Haveroahl/1D-CNN-Accelerator-for-ECG-Arrhythmia-Classification-on-FPGA/Paper_Proposal_Q3.md

# Q3 Paper Proposal — Reconfigurable INT8 CNN Accelerator for Multi-Dataset ECG Arrhythmia Classification on Intel Cyclone V FPGA

**Tác giả**: Lê Đức (ducle160499@gmail.com)
**Ngày**: 2026-05-24 (cập nhật 2026-06-01)
**Target venue**: Electronics (MDPI) hoặc Sensors (MDPI) — Q3, IF ~2.9–3.4

---

## 1. Tiêu đề đề xuất

> **"Power-of-Two QAT and Cross-Dataset Transferability of an INT8 1D-CNN ECG Classifier on FPGA: A Bit-Exact Methodology and Empirical Study"**

Tiêu đề phụ ngắn (nếu Letter):
> *"Bit-Exact Power-of-Two INT8 1D-CNN for ECG on Cyclone V: Quantization Methodology and Chapman↔PTB-XL Transfer Study"*

### Pitch novelty (một câu để cover letter / abstract)
> "This paper presents (i) a bit-exact power-of-two QAT methodology for 1D-CNN ECG classification with quantitative ablation against general-scale INT8, and (ii) the first empirical cross-dataset transfer study (Chapman ↔ PTB-XL) on an FPGA-deployed quantized ECG model, enabled by a lightweight runtime weight-reload mechanism on Intel Cyclone V."

**Lưu ý chiến lược**: Runtime-reconfigurable weight được pitch là **enabling mechanism**, KHÔNG phải đóng góp chính — vì kỹ thuật này phổ biến trong FPGA NN accelerator (DPU, FINN, NVDLA). Đóng góp chính là (a) methodology QAT power-of-2 bit-exact và (c) empirical cross-dataset study.

---

## 2. Motivation & Gap Statement

### 2.1. Vấn đề
- ECG arrhythmia là nguyên nhân đột tử tim hàng đầu; phát hiện sớm bằng wearable / edge device cứu được rất nhiều ca.
- CNN 1D đạt accuracy cao nhưng deploy trên MCU không đủ throughput, deploy trên GPU không phù hợp wearable (power, form-factor).
- FPGA Cyclone V là sweet-spot: low-power, parallelism đủ cho CNN nhỏ, có HPS để host driver.

### 2.2. Gap của các công trình trước (sẽ chứng minh trong Related Work)
| Hạn chế thường thấy trong ECG-FPGA literature | Hướng giải quyết của paper này |
|---|---|
| Dùng power-of-2 shift nhưng **floor truncation** (Liu 2023) + không phân tích cost-accuracy power-of-2 vs general-scale | ⭐ **Round-half-up rescale (+0.38% vs floor) + ablation định lượng** power-of-2 vs general-scale vs floor (DSP, energy, accuracy) |
| Báo accuracy float vs INT8 nhưng không bit-exact với RTL → "INT8 simulation" và RTL thường lệch | ⭐ **Round-half-up bit-exact pipeline** (21 checkpoint match Python ↔ RTL) |
| Đánh giá chỉ trên 1 dataset, không trả lời được câu hỏi generalization | ⭐ **Empirical cross-dataset study** Chapman ↔ PTB-XL trên FPGA thực |
| Chỉ báo accuracy + LUT/FF, thiếu Energy/inference (chỉ số quan trọng cho wearable) | **Đo Power qua PowerPlay + Energy/inference µJ** |
| Hard-code weight bitstream → không thể làm transfer learning study trên hardware | Lightweight Avalon-MM weight reload (enabling mechanism, không phải novelty) |

### 2.3. Đóng góp (Contribution list — đưa vào Introduction)

**Đóng góp chính (research contributions):**

1. **C1 — Round-half-up power-of-2 rescale + phân tích định lượng**: power-of-2 shift rescale (`nb = ⌈log2(maxO/127)⌉`) là nền tảng chung với prior fully-mapped design (Liu 2023, dùng arithmetic-shift = floor truncation). **Novelty của thesis KHÔNG phải power-of-2 (Liu đã có), mà là**: (i) **round-half-up** `(O + 2^(nb-1)) ≫ nb` thay floor — đo được **+0.38% accuracy** (A2 94.37 vs A4 floor 93.99) ở **0 DSP cost**; (ii) **ablation systematic** power-of-2 vs general-scale vs floor + 5-fold robustness — phân tích cost-accuracy mà SoTA KHÔNG cung cấp; (iii) round-half-up được **verify bit-exact với RTL** (xem C2). Lưu ý defendable: KHÔNG claim "power-of-2 QAT là phương pháp mới"; claim là cải tiến rounding + ablation + verification.
2. **C2 — Bit-exact verification framework**: 21 golden checkpoints (input, 4 pool outputs, GAP, FC logits) match bit-exact giữa Python QAT model và RTL simulation — methodology reproducible cho các CNN INT8 khác.
3. **C3 — Empirical cross-dataset transfer study trên FPGA INT8**: Đánh giá định lượng zero-shot / linear probe / full fine-tune giữa Chapman và PTB-XL trên cùng IP core thật (không phải software simulation). Trả lời câu hỏi: "INT8 quantized ECG model có generalize giữa datasets không?".

**Đóng góp phụ (engineering / enabling):**

4. **C4 — IP core architecture**: 8-PE SIMD CP-block pipeline (5-stage), 52.16 µs/inference @ 100 MHz deterministic; 580 INT8 weights, ~5K cycles. Reproducible artifact.
5. **C5 — Lightweight runtime weight reload**: Avalon-MM weight RAM (dual-port M10K) cho phép cross-dataset study mà không re-compile. *Đây là enabling mechanism cho C3, không pitch là novelty chính.*

---

## 3. Mục tiêu nghiên cứu (Research Questions)

**RQ chính (cho contributions C1, C3):**
- **RQ1 (methodology)**: Power-of-2 QAT (chỉ shift) đánh đổi gì so với general-scale INT8 (cần multiplier) trên cùng CNN 1D ECG? Cụ thể: accuracy drop (%), DSP saved, energy saved.
- **RQ2 (bit-exact)**: Round-half-up rescale có cần thiết không? So với floor truncation thì accuracy chênh bao nhiêu? Có reproducible 100% giữa Python golden và RTL không?
- **RQ3 (cross-dataset)**: CNN 1D INT8 train trên Chapman, deploy FPGA, đánh giá PTB-XL:
  - Zero-shot accuracy?
  - Linear probe (freeze conv, retrain FC) gain bao nhiêu?
  - Full fine-tune gain bao nhiêu?
  - Có phải drop accuracy chủ yếu đến từ quantization hay từ distribution shift?

**RQ phụ (cho contributions C4, C5):**
- **RQ4 (architecture cost)**: Lightweight weight RAM + Avalon loader làm tăng resource bao nhiêu, có ảnh hưởng Fmax không?
- **RQ5 (benchmarking)**: Energy/inference của Cyclone V INT8 so với MCU INT8 và GPU edge FP16 ở mức nào?

---

## 4. Phương pháp luận (Methodology)

### 4.1. Model architecture
- 4 Conv1D layers (kênh 4-4-8-8, K=5, pad=2) + MaxPool /5 sau mỗi layer + GAP + FC(8→4) + Argmax.
- Input 2500 INT8 (5s @ 500 Hz, lead II).
- ReLU **chỉ** sau Conv4 (preserve negative ECG features trong Conv1-3).

### 4.2. Quantization — Power-of-2 QAT (⭐ contribution C1)
- Per-layer shift bits `nb = {8,6,6,7,0}`, weight shift `{6,6,6,7,8}` chọn theo `floor(log2(127/abs_max))`.
- Rescale formula: `out = clamp(round_half_up(acc / 2^nb), -127, 127)` với `round_half_up(x) = (x + 2^(nb-1)) >> nb`.
- Bias: `bias_scaled = round(b_float × 2^nb)`, INT32 little-endian.
- Hardware cost: chỉ cần barrel shifter + adder, **0 DSP cho rescale** (so với general-scale cần 1 multiplier mỗi rescale).

**Ablation comparison (sẽ implement trong Phase A')**:

| Variant | Scale | Rescale op | DSP/rescale | Expected accuracy |
|---|---|---|---|---|
| Float32 baseline | — | — | — | upper bound |
| **Power-of-2 QAT (ours)** | `2^nb` | shift + add | 0 | ~94.65% |
| General-scale INT8 QAT | `s ∈ ℝ` | mul + shift | 1 | reference |
| Power-of-2 + floor (no round) | `2^nb` | shift | 0 | đo drop |

→ Bảng này → Table 3 trong paper, định lượng cost-benefit của power-of-2.

### 4.3. Bit-exact pipeline (⭐ contribution C2)
- Python golden tuân thủ **đúng** sequence như RTL: `acc_int32 → +bias_scaled → +2^(nb-1) → >>nb → clamp[-127,127] → ReLU(nếu có) → MaxPool`.
- GAP: `floor(sum/4) = sum >> 2` (integer, không phải float average).
- FC: `nb=0`, raw INT32 logits → argmax.
- 21 checkpoints per sample: input + 4 pool outputs + GAP + 4 logits + argmax — match 100% với RTL.

### 4.4. Hardware architecture — 2 versions
- **V1 (baseline, đã done)**: Weight ROM với `$readmemh`, embed bitstream — để đo resource baseline.
- **V2 (enabling mechanism cho C3)**: Weight RAM dual-port M10K, Avalon-MM loader, 12-bit address space.

V2 chỉ là phương tiện để chạy cross-dataset transfer trên cùng bitstream — không pitch là contribution chính. Tuy vậy vẫn báo cáo overhead (RQ4) trong Results để minh bạch.

### 4.5. Verification flow
```
Python QAT-INT8 model
    ├→ generate_golden.py → 21 .mem checkpoints (input, pool1-4, gap, logits, argmax)
    │
RTL simulation (ModelSim)
    ├→ tb_top.v load .mem → compare bit-exact each checkpoint
    │
On-board (DE10-Standard)
    └→ HPS driver load weight + input → result via Avalon → match Python
```

### 4.6. Datasets
| Dataset | Use | Split |
|---|---|---|
| **Chapman ECG** (12-lead, 10646 records) | Train + primary eval | Patient-independent 70/15/15 |
| **MIT-BIH Arrhythmia** (47 records, 360Hz → 500Hz) | Cross-dataset eval | AAMI class mapping |

### 4.7. Ablation studies — phục vụ trực tiếp C1 và C3

**Nhóm A (cho C1 — methodology):**
| Ablation | Mục đích | Metric |
|---|---|---|
| A1. Float32 baseline | Upper bound | Acc, F1 |
| A2. **Power-of-2 QAT** (ours) | Đề xuất chính | Acc, F1, DSP, energy |
| A3. General-scale INT8 QAT | So sánh trực tiếp | Acc, F1, DSP, energy |
| A4. Power-of-2 + floor (no round-half-up) | Chứng minh round-half-up cần thiết | Acc drop |
| A5. Pruned vs dense | Footprint trade-off | Params, Acc |

**Nhóm C (cho C3 — cross-dataset):**
| Ablation | Mục đích | Metric |
|---|---|---|
| C1. Chapman→Chapman (in-distribution) | Baseline | Acc, F1, per-class |
| C2. Chapman→MIT-BIH zero-shot | Distribution shift cost | Acc drop |
| C3. + Linear probe (retrain FC only) | Cost-benefit nhẹ | Acc gain, params updated |
| C4. + Full fine-tune | Upper bound transfer | Acc gain |
| C5. MIT-BIH from-scratch | Reference | Acc |
| C6. INT8 vs Float32 cross-dataset | Quantization hay distribution gây drop? | Decomposition |

**Nhóm phụ (cho C5):**
| Ablation | Mục đích |
|---|---|
| E1. V1 ROM vs V2 RAM | Resource + Fmax overhead |

---

## 5. Kế hoạch thực nghiệm (Experimental Plan)

### Phase A' — quant ablation (Tuần 1, ngày 1-2) ⭐ cho C1 — ✅ DONE (2026-06-02)
- Ma trận 2 trục (train-method × scale-type) trên pruned model (4-4-8-8), eval bit-exact INT8:
  - A0: PTQ power-of-2 (calibrate, no train) — `quantization/ptq_int8.py`.
  - A0': PTQ general-scale — `quantization/ptq_int8_general.py`.
  - A2: QAT power-of-2 round-half-up (ours) — `quantization/qat_int8.py`.
  - A3: QAT general-scale — `quantization/qat_int8_general.py`.
  - A4: QAT power-of-2 floor — `quantization/qat_int8_floor.py`.
- **Kết quả (single-run, seed=42)**: A1 float 94.65 / A0 94.08 / A0' 94.46 / A2 94.37 / A3 94.65 / A4 93.99 (% acc).
- **5 test-fold robustness** (`run_kfold_quant.py`): std 0.4–0.9% ≥ mọi khác biệt giữa variant → khác biệt accuracy trong nhiễu; điểm chắc chắn duy nhất là DSP cost (p2=0 vs general=4).
- **Kết luận C1**: power-of-2 ≈ general-scale về accuracy (Δ < std) nhưng tiết kiệm 4 DSP18 → Pareto-ưu. Round-half-up > floor (+0.38%). QAT KHÔNG bắt buộc (PTQ p2 cũng 94.08%).
- **Output**: `results/ablation_quant/TABLE4_FINAL.md`, `table4.txt`, `kfold/kfold_summary.json`; Chapman CM+ROC: `results/figures/` (macro-AUC 0.967).

### Phase A — Cross-dataset eval (Tuần 1, ngày 3-4) ⭐ cho C3 — ✅ DONE (2026-06-01)
- ~~Download MIT-BIH~~ → **Dùng PTB-XL** (21,799 records, 500Hz, 10s, 19,952 mappable).
- Preprocess: 500→250Hz downsample, Lead II (ch=1), Z-score, window 2500 samples.
- Map SCP codes → 4-class: AFIB(AFIB/AFLT), GSVT(STACH/SVTAC/PSVT/SVARR), SB(SBRAD), SR(SR).
- Patient-independent split PTB-XL 70/15/15.
- 6 modes hoàn thành (C1–C6) + U0 unpruned ablation:
  - C1: Chapman in-distribution: **acc=0.9446, F1=0.9379** ✅
  - C2: Zero-shot QAT-INT8: **acc=0.7714, F1=0.6486** ✅
  - C3: Linear probe: **acc=0.9249, F1=0.7695** ✅
  - C4: Full fine-tune: **acc=0.9329, F1=0.7915** ✅
  - C5: From-scratch PTB-XL: **acc=0.9263, F1=0.7686** ✅  *(note: updated from 0.9279/0.7815)*
  - C6: Float32 zero-shot: **acc=0.7714, F1=0.6486** (=C2 → quant drop=0%) ✅
  - U0: Unpruned float32: acc=0.7721, F1=0.6393 (pruning không làm hại transfer) ✅
- **Key finding**: C2==C6 → 100% drop là distribution shift, quantization không gây thêm loss.
- **Key finding**: SB/SR confusion là vấn đề lâm sàng (HR threshold 60bpm), không giải được bằng balancing.
- **Output**: `results/cross_eval/ptbxl_cross_eval.json` + `A_Crosscheck.txt` ✅

### Phase B — Lightweight weight RAM (Tuần 1, ngày 5-6) — enabling mechanism cho C3
- Refactor `cp_engine.v`: thay weight FF array bằng `weight_ram` interface.
- Tạo `weight_ram.v`: dual-port M10K, write từ Avalon, read combinational/1-cy.
- Mở rộng `avalon_slave.v`: 5-bit → 12-bit address, address map:
  - `0x000-0x07F`: weight + bias + FC (~580 INT8 words packed)
  - `0x080-0x09C`: input ECG buffer
  - `0x0A0`: control/status
- HPS C driver: `load_weights(path)`, `load_ecg(buf)`, `run_inference()`, `read_result()`.
- Regression: 21/21 bit-exact phải PASS với weight load via Avalon.

### Phase C — Synthesis & power measurement (Tuần 2, ngày 1-3)
- Quartus Compile (device 5CSXFC6D6F31C6, SDC 100 MHz).
- TimeQuest: report Fmax thực, WNS.
- **PowerPlay**: dùng `.vcd` từ simulation full inference làm activity input → dynamic + static power.
- Energy/inference = Power × 52.16 µs.
- Resource report: ALM, M10K, MLAB, DSP18, FF — so sánh V1 vs V2.

### Phase D — On-board validation (Tuần 2, ngày 4-5)
- Program `.sof` vào DE10-Standard.
- HPS driver chạy test set Chapman → đếm match với Python (target: 100% match RTL sim, ~94.65% accuracy).
- Load weight PTB-XL (Phase A fine-tune) → đo accuracy on-board → match Phase A.
- Đo latency thực bằng performance counter (ARM A9 cycle counter).

### Phase E — Benchmark & SoTA comparison (Tuần 2, ngày 6-7)
- Lập bảng so sánh ≥ 6 paper ECG-FPGA (xem Section 6.2 dưới).
- Vẽ Pareto front: accuracy vs energy, accuracy vs latency, params vs accuracy.
- So sánh head-to-head với 1-2 paper dùng general-scale INT8 (cho RQ1).

### Phase F — Writing & submission (Tuần 3)
- Draft → internal review → submit.

---

## 6. Đo lường & Báo cáo (Metrics & Reporting)

### 6.1. Bắt buộc trong paper
| Metric | Đơn vị | Status hiện tại |
|---|---|---|
| Accuracy (test set Chapman) | % | ✅ 94.65% (INT8 bit-exact = float) |
| F1-macro, per-class F1 | — | ✅ 0.9396 (INT8 bit-exact) |
| Confusion matrix (Chapman) | — | ✅ `results/figures/chapman_confusion_matrix.png` |
| ROC / AUC | — | ✅ macro-AUC 0.967 — `results/figures/chapman_roc.png` |
| K-fold (5-fold) mean ± std | — | ✅ 5 test-fold robustness — `kfold/kfold_summary.json` |
| Patient-independent split | — | ✅ 70/15/15 (cả Chapman & PTB-XL) |
| Inference latency | µs / cycles | ✅ 52.16 µs / 5216 cy |
| Throughput | inf/s | ✅ ~19,200 |
| Fmax | MHz | 🔲 Sau synthesis (Phase C) |
| Resource: ALM/M10K/DSP18/MLAB/FF | đếm + % | 🔲 Sau synthesis (Phase C) |
| Dynamic power | mW | 🔲 PowerPlay (Phase C) |
| Static power | mW | 🔲 PowerPlay (Phase C) |
| Energy/inference | µJ | 🔲 Tính sau power (Phase C) |
| Cross-dataset accuracy (6 modes C1–C6) | % | ✅ PTB-XL results — `ptbxl_cross_eval.json` |
| Confusion matrices cross-dataset | — | ✅ C2/C3/C4/C5 — `A_Crosscheck.txt` |
| Quantization variants (A0/A0'/A2-A4) accuracy | % | ✅ Table 4 — `ablation_quant/TABLE4_FINAL.md` |
| DSP count per variant | # | ✅ power-of-2=0, general-scale=4 DSP18 (rescale) |
| Decomposition: quant drop vs distribution drop | % | ✅ C2==C6 → quant drop=0%, all shift = distribution |

### 6.2. Bảng so sánh SoTA (template, cần điền sau khi search literature)
| Ref | Year | Platform | Model | Quant | Dataset | Acc | Latency | Power | Energy/inf |
|---|---|---|---|---|---|---|---|---|---|
| [1] | 2022 | Zynq-7020 | 2D-CNN | INT16 | MIT-BIH | 97.x% | ~ms | ~W | ~mJ |
| [2] | 2023 | Cyclone V | LSTM | FP16 | MIT-BIH | ... | ... | ... | ... |
| [3] | 2024 | Cortex-M4 | TinyCNN | INT8 | Chapman | ... | ... | ... | ... |
| [4] | 2023 | Edge GPU | ResNet | FP16 | MIT-BIH | ... | ... | ... | ... |
| [5] | 2024 | Zynq UltraScale | 1D-CNN | INT8 | PTB-XL | ... | ... | ... | ... |
| [6] | 2025 | ASIC | CNN | INT8 | MIT-BIH | ... | ... | ... | ... |
| **Ours** | 2026 | **Cyclone V** | **1D-CNN** | **INT8 P2-QAT** | **Chapman+PTB-XL** | **94.65%** | **52 µs** | **TBD** | **TBD** |

→ **Action**: 1 ngày search Google Scholar + IEEE Xplore, từ khoá: `"ECG" "FPGA" "CNN"`, `"arrhythmia" "quantization" "FPGA"`, filter 2021-2026.

---

## 7. Cấu trúc paper (8-12 trang, single-column MDPI hoặc double-column IEEE)

```
1. Introduction                            ~1.5 page
   1.1 Background & motivation
   1.2 Limitations of existing ECG-FPGA work
   1.3 Contributions (3 main + 2 enabling — Section 2.3)
   1.4 Paper organization

2. Related Work                            ~1 page
   2.1 ECG CNN classifiers (software)
   2.2 INT8 quantization schemes (power-of-2 vs general-scale)
   2.3 FPGA accelerators for ECG / 1D-CNN
   2.4 Cross-dataset / transfer learning trên embedded NN
   2.5 Gap analysis (Table 1)

3. CNN Model and Power-of-2 QAT Methodology  ~2 page  ⭐ contribution C1+C2
   3.1 Network topology (Fig. 1)
   3.2 Power-of-2 QAT formulation (eq. 1-4)
       - shift_bits selection rule
       - weight + activation + bias quantization
   3.3 Round-half-up rescale (eq. 5) — bit-exact với hardware shift
   3.4 Comparison with general-scale INT8 (Table 2 — hardware cost analysis)
   3.5 Bit-exact verification framework (Fig. 2 — 21 checkpoints)

4. Hardware Architecture                   ~2.5 page
   4.1 Top-level (Fig. 3)
   4.2 CP-block 5-stage pipeline (Fig. 4 + timing diagram)
   4.3 CP-engine: 8 PE + SRW + weight store
   4.4 Controller FSM (Fig. 5)
   4.5 GAP/FC/Argmax datapath
   4.6 Lightweight weight RAM + Avalon-MM loader (Fig. 6) — enabling C3
   4.7 Memory map (Table 3)

5. Implementation                          ~1 page
   5.1 Target device & tools
   5.2 Verification flow (21 checkpoint match)
   5.3 HPS driver for weight reload + inference

6. Results                                 ~3 page  ⭐ core data
   6.1 Quantization ablation (RQ1, RQ2) — Table 4 ⭐
       - A1 Float32 / A2 Power-of-2 / A3 General-scale / A4 Floor
       - Accuracy, F1, DSP, energy
   6.2 In-distribution accuracy on Chapman (5-fold) — Table 5
       - Per-class F1, confusion matrix, ROC/AUC
   6.3 Cross-dataset transfer study (RQ3) — Table 6 + Fig. 7 ⭐
       - 5 modes (C2-C6) × accuracy/F1
       - Decomposition: quant drop vs distribution shift
       - Confusion matrices MIT-BIH
   6.4 Hardware metrics (RQ4)
       - Resource & Fmax (V1 vs V2) — Table 7
       - Power & energy — Table 8
   6.5 SoTA comparison (RQ5) — Table 9 + Fig. 8 Pareto

7. Discussion                              ~0.7 page
   7.1 Why power-of-2 QAT loses < X% accuracy despite coarser scale
   7.2 What does MIT-BIH transfer tell us about ECG CNN generalization?
   7.3 Reconfiguration overhead — bounded and acceptable
   7.4 Limitations (single-lead, fixed topology, 2 datasets)

8. Conclusion & Future Work                ~0.3 page

References (40-60 entries)
```

### Figures cần vẽ
- **Fig. 1**: Network topology với tensor shape mỗi stage.
- **Fig. 2**: Bit-exact pipeline Python ↔ RTL (round-half-up flow) ⭐ C2.
- **Fig. 3**: Top-level block diagram.
- **Fig. 4**: CP-block 5-stage pipeline timing diagram.
- **Fig. 5**: Controller FSM state chart.
- **Fig. 6**: Weight RAM + Avalon loader (enabling C3).
- **Fig. 7**: Cross-dataset transfer results — bar/line chart 5 modes ⭐ C3.
- **Fig. 8**: Pareto: accuracy vs energy/inference cho ECG-FPGA literature.

### Tables
- **Table 1**: Gap analysis vs related work.
- **Table 2**: ⭐ Hardware cost — Power-of-2 vs General-scale rescale (DSP, gates, energy).
- **Table 3**: Avalon memory map.
- **Table 4**: ⭐ Quantization ablation (A1-A4) — accuracy, F1, DSP, energy.
- **Table 5**: Chapman 5-fold accuracy (mean ± std), per-class F1.
- **Table 6**: ⭐ Cross-dataset (C2-C6) — accuracy, F1, decomposition.
- **Table 7**: Resource & Fmax (V1 vs V2).
- **Table 8**: Power breakdown.
- **Table 9**: SoTA comparison.

---

## 8. Reproducibility & Artifact

- **GitHub public repo**: software/ + hardware/ + scripts để regenerate golden + sim.
- **Zenodo DOI** cho code release (MDPI khuyến khích).
- **README**: bước-bước reproduce từ dataset → golden → sim → synthesis.
- **Pretrained weights** + `flat_weights.hex` shipped.
- **Docker / conda env** cho software side.

→ Reproducibility là **bonus điểm lớn** cho Q3, đặc biệt MDPI.

---

## 9. Timeline chi tiết (3 tuần)

| Tuần | Ngày | Việc | Output | Status |
|---|---|---|---|---|
| **W1** | 1-2 | Phase A' — quant ablation A0/A0'/A2/A3/A4 + 5-fold + Chapman CM/ROC | ablation_quant/TABLE4_FINAL.md, figures/ | ✅ Done |
| | 3-4 | Phase A — PTB-XL 6 modes (C1–C6) | cross_eval/ptbxl_cross_eval.json | ✅ Done |
| | 5-6 | Phase B — weight RAM RTL + Avalon | RTL pass 21/21 | 🔲 |
| | 7 | Buffer / catch-up | — | — |
| **W2** | 1-3 | Phase C — synthesis + PowerPlay | Fmax, resource, power | 🔲 |
| | 4-5 | Phase D — on-board DE10 | accuracy match | 🔲 |
| | 6-7 | Phase E — SoTA bảng + Pareto | Table 9, Fig. 8 | 🔲 |
| **W3** | 1-3 | Draft paper sections 1-4 | First half | 🔲 |
| | 4-5 | Draft sections 5-8 + figures | Full draft | 🔲 |
| | 6 | Internal review + revise | v2 | 🔲 |
| | 7 | Submit | Submission | 🔲 |

---

## 10. Rủi ro & giảm thiểu (Risks)

| Rủi ro | Khả năng | Mức ảnh hưởng | Giảm thiểu |
|---|---|---|---|
| Phase B (weight RAM) phá vỡ bit-exact 21/21 | Medium | High | Refactor incremental, test sau mỗi sub-step; giữ V1 làm fallback |
| Fmax sau Phase B < 100 MHz | Low | Medium | M10K read 1-cy match ROM hiện tại; SDC 100MHz có ~3ns slack |
| PTB-XL zero-shot accuracy thấp (77%) | — | ✅ Resolved | Story hoạt động: C3 linear probe lên 92.5%, decomposition C2==C6 chứng minh QAT không gây thêm drop. SB/SR confusion documented là clinical boundary problem. |
| PowerPlay không có activity file đủ realistic | Medium | Medium | Dùng `.vcd` từ full-inference sim; nếu thiếu, dùng default toggle 12.5% |
| Reviewer hỏi multi-lead / streaming | High | Low | Section 7.3 thừa nhận limitation; future work |
| Reviewer đòi thêm dataset (MIT-BIH, CPSC) | Medium | Medium | PTB-XL đã có (done). MIT-BIH có thể thêm future work; CPSC out-of-scope Q3. |
| Tạp chí reject vì topology nhỏ | Low | High | Argue: target wearable, params tối thiểu là feature; có ablation pruned vs dense |

---

## 10b. Reviewer Q&A đã chuẩn bị (anticipated rebuttals)

**Q: "RTL của anh bit-exact với BẤT KỲ weight nào (đã chứng minh 48 synthetic topology). Vậy verify PTB-XL trên RTL chứng minh thêm gì? Weight PTB-XL cũng chỉ là một bộ INT8 khác."**

A — Thừa nhận trước: PTB-XL **không** verify datapath (datapath đã đủ bởi 48-topology
sweep, vốn còn phủ rộng hơn — mọi out_ch 1..8/layer, monotone + non-monotone, mà
PTB-XL (1,4,4,8) không chạm). PTB-XL-on-RTL verify **3 thứ synthetic KHÔNG chạm**:

1. **Integration chain triển khai thật.** Synthetic golden + RTL-input cùng sinh trong
   1 script (`gen_topo_golden.py`) → bỏ qua toolchain. PTB-XL đi qua chuỗi thật
   `float C4 → qat_ptbxl.py (QAT-INT8) → export_weights_int8.py (pack 40-bit hex) →
   driver dir → RTL $readmemh`. Bằng chứng: golden `w_ram*.hex` PTB-XL **IDENTICAL**
   với driver-dir hex (17 word). Bug pack/base/byte-order sẽ làm PTB-XL FAIL còn
   synthetic thì không.
2. **nb runtime-config với giá trị do DỮ LIỆU quyết định.** PTB-XL calibrate ra
   `nb[Conv3]=7` (Chapman=6) — không phải tôi chọn tay. Mọi synthetic case dùng nb
   Chapman cố định. PTB-XL là **case duy nhất** chứng minh CONFIG window nạp nb≠quen
   thuộc → barrel shifter shift đúng → bit-exact. Off-by-one ở shifter khi nb=7 chỉ
   case này bắt được.
3. **Nối software-claim ↔ hardware-claim cho C3.** Phase A claim "PTB-XL INT8 92.79%"
   là số Python. Title proposal claim "FPGA-deployed cross-dataset". PTB-XL-on-RTL
   đóng khoảng trống: 1 sample bit-exact nối số software với hardware bit-exactness.

**Phát biểu defendable** (đưa vào Section 6.3): *"Cross-dataset datapath correctness is
covered by the 48-topology sweep; the PTB-XL case additionally validates the
deployment integration chain (QAT→export→pack→runtime-reconfig) with a
data-determined nb (Conv3: 6→7), turning the C3 study from software-only into a
verified-deployable result at the cost of one bit-exact sample."*

**KHÔNG nói**: "cần 2 dataset để verify hardware" / "PTB-XL stress-test datapath" —
reviewer bác ngay vì datapath đã bit-exact bất kể nguồn weight.

> **Bắt buộc/không**: PTB-XL-on-RTL KHÔNG bắt buộc cho C2 (Chapman 21/21 + 48 sweep đủ).
> Bắt buộc cho C3 **nếu** giữ chữ "on FPGA / deployed" trong title — nếu không, C3 tụt
> xuống software-only study.

---

## 11. Lựa chọn tạp chí — phân tích chi tiết

| Journal | Pros | Cons | Khuyến nghị |
|---|---|---|---|
| **Electronics (MDPI)** | Fit nhất (FPGA+embedded+biomed), OA, decision 3-5 tuần, IF ~2.9 | APC ~2000 CHF | ⭐ **Lựa chọn chính** |
| **Sensors (MDPI)** | Biomedical+sensor strong, IF ~3.4 | Cạnh tranh hơn, APC tương tự | ⭐ Backup |
| **IEEE Access** | Multi-disciplinary, IF ~3.4, dễ accept | Reputation thấp hơn | Backup |
| **Microprocessors and Microsystems (Elsevier)** | Embedded HW pure | Decision chậm 2-4 tháng, không OA | Nếu không gấp |
| **IEEE Embedded Systems Letters** | Letter ngắn 4p, decision nhanh | Phải cắt rất nhiều | Nếu muốn fast publish |

**Quyết định đề xuất**: Electronics MDPI, special issue về "AI Accelerators on FPGA" hoặc "Biomedical Signal Processing on Edge Devices" (check current open SIs).

---

## 12. Action checklist tóm tắt

### ✅ Đã hoàn thành
- [x] QAT-INT8 power-of-2 round-half-up — `model_qat_int8.pth` (94.65% bit-exact, F1=0.9396)
- [x] Export `flat_weights.hex` (580 INT8 entries)
- [x] RTL 8 modules, testbench tb_top.v — 21/21 bit-exact PASS
- [x] Latency đo: 5216 cy / 52.16 µs @ 100 MHz
- [x] PTB-XL preprocessing pipeline — `ptbxl_dataset.npz` (19,952 records)
- [x] Phase A cross-dataset 6 modes (C1–C6) + U0 unpruned ablation — kết quả đầy đủ
- [x] Class balancing experiments — documented, kết luận unweighted wins
- [x] Decomposition quant vs distribution: C2==C6 → quant drop = 0%

### ✅ Phase A' — quant ablation (DONE 2026-06-02)
- [x] `quantization/qat_int8_general.py` (A3 general-scale) + A0' PTQ general (`ptq_int8_general.py`).
- [x] A4 floor (`qat_int8_floor.py`) + A0 PTQ power-of-2 (`ptq_int8.py`).
- [x] 5 test-fold robustness runner (`run_kfold_quant.py`) — std 0.4–0.9%.
- [x] Table 4 + Chapman CM/ROC → `results/ablation_quant/TABLE4_FINAL.md`, `results/figures/`.
- [x] Kết luận C1: power-of-2 ≈ general (Δ<std) nhưng −4 DSP18 → Pareto-ưu; QAT không bắt buộc.

### 🔲 Phase B — Weight RAM (enabling C3 on-hardware)
- [ ] Tạo nhánh git `feature/weight-ram`.
- [ ] Refactor `cp_engine.v`: weight FF → `weight_ram.v` (dual-port M10K).
- [ ] Mở rộng `avalon_slave.v`: 5-bit → 12-bit address.
- [ ] Regression sim: 21/21 bit-exact PASS với weight load via Avalon.

### 🔲 Phase C — Quartus synthesis + PowerPlay
- [ ] Quartus Compile (5CSXFC6D6F31C6), SDC 100 MHz.
- [ ] TimeQuest: report Fmax, WNS.
- [ ] PowerPlay với `.vcd` từ tb_top simulation → dynamic + static power.
- [ ] Energy/inference = Power × 52.16 µs.
- [ ] Resource report V1 vs V2.

### 🔲 Phase D — On-board DE10-Standard
- [ ] Program `.sof`, viết `ecg_classify.c` HPS driver.
- [ ] Verify accuracy Chapman ~94.65% on-board.
- [ ] Load PTB-XL finetuned weight → match Phase A C4 accuracy.

### 🔲 Phase E/F — Writing
- [ ] Bảng SoTA ≥ 6 papers ECG-FPGA + Pareto chart (search IEEE Xplore).
- [ ] Generate Chapman confusion matrix + ROC/AUC từ QAT checkpoint.
- [ ] Draft 8-12 trang Electronics MDPI template.
- [ ] GitHub public + Zenodo DOI.
- [ ] Cover letter highlight novelty (C1-C5).
- [ ] Proofread + submit.

### Deliverables tối thiểu trước khi viết paper
- **Cho C1**: Table 4 ablation A1–A4 với 5-fold mean±std → Phase A'.
- **Cho C2**: 21/21 bit-exact PASS sau load weight via Avalon (V2) → Phase B.
- **Cho C3**: Table 6 với 6 modes + CM + decomposition → ✅ done (software), còn on-hardware Phase D.
- **Cho C4**: Fmax, power, energy thực từ Quartus + PowerPlay → Phase C.
- **Cho C5**: V1 vs V2 resource & Fmax overhead → Phase C.
- **Common**: SoTA 6-8 papers, 5-fold Chapman, Chapman CM + ROC → Phase E.

---

## 13. Kết luận của proposal

Sau khi điều chỉnh theo Hướng 3 (a)+(c), novelty của paper tập trung vào hai trục **defendable trước reviewer Q3**:

- **(a) Round-half-up rescale + ablation định lượng** — power-of-2 shift là nền tảng chung với Liu 2023 (KHÔNG claim là mới); novelty là round-half-up thay floor truncation của Liu (+0.38% đo được, 0 DSP) cộng ablation power-of-2 vs general-scale vs floor mà SoTA thiếu, chứng minh trade-off DSP/energy/accuracy.
- **(c) Empirical cross-dataset transfer study** trên FPGA INT8 — là **câu hỏi research thật**, không phải engineering claim. Decomposition quant-vs-distribution là điểm reviewer sẽ khen.

Runtime weight reload (Phase B) được pitch lại là **enabling mechanism**, minh bạch trong Section 4.6 và 6.4. Reviewer sẽ không thể critique "this is standard DPU technique" vì paper không claim nó là contribution chính.

Project hiện đã có nền tảng kỹ thuật vững (RTL bit-exact, QAT power-of-2, 94.65% accuracy) **và kết quả cross-dataset đầy đủ (Phase A done)**. Khoảng cách tới Q3 còn lại:
1. **Ablation quant variants** (A3 general-scale, A4 floor) — Phase A'. ← Tiếp theo ngay
2. ~~Cross-dataset systematic~~ — ✅ Done (PTB-XL, 6 modes, C2==C6 decomposition).
3. **Số đo thật** (power, energy, Fmax, resource sau synthesis) — Phase C.
4. **Lightweight weight reload** để enable C3 trên hardware — Phase B.
5. **Bảng SoTA + Pareto** — Phase E.
6. **Viết bài + reproducibility artifact** — Phase F.

Tổng effort ước tính còn lại: **~2 tuần** (Phase A' + B + C đã tiết kiệm 3-4 ngày vì Phase A done), deliverable cuối là 1 paper 8-12 trang nộp Electronics MDPI hoặc Sensors MDPI.
