Haveroahl/1D-CNN-Accelerator-for-ECG-Arrhythmia-Classification-on-FPGA/hardware/docs/diagrams/01_ecg_accelerator_top.png

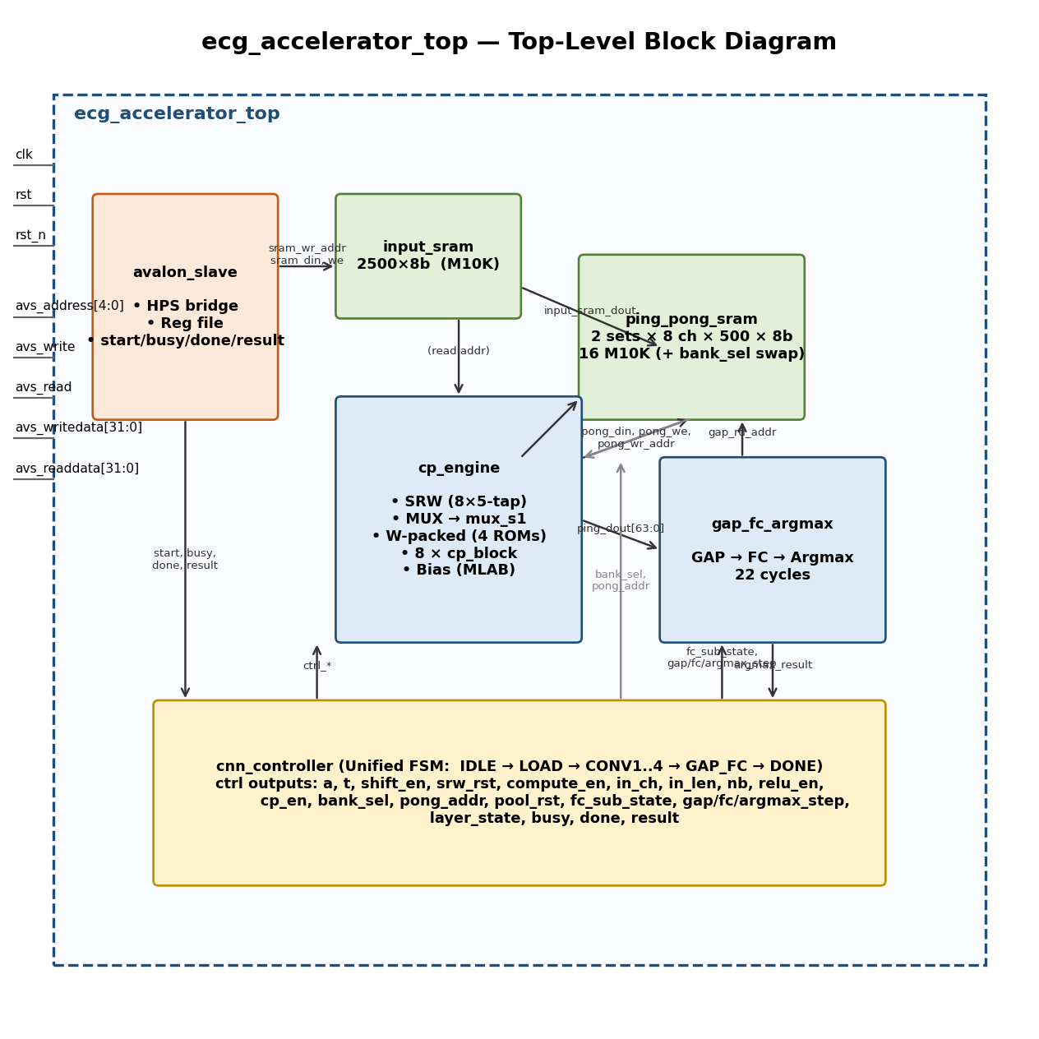
hardware/docs/diagrams/01_ecg_accelerator_top.png
