Haveroahl/1D-CNN-Accelerator-for-ECG-Arrhythmia-Classification-on-FPGA/hardware/docs/diagrams/02_cp_block.png

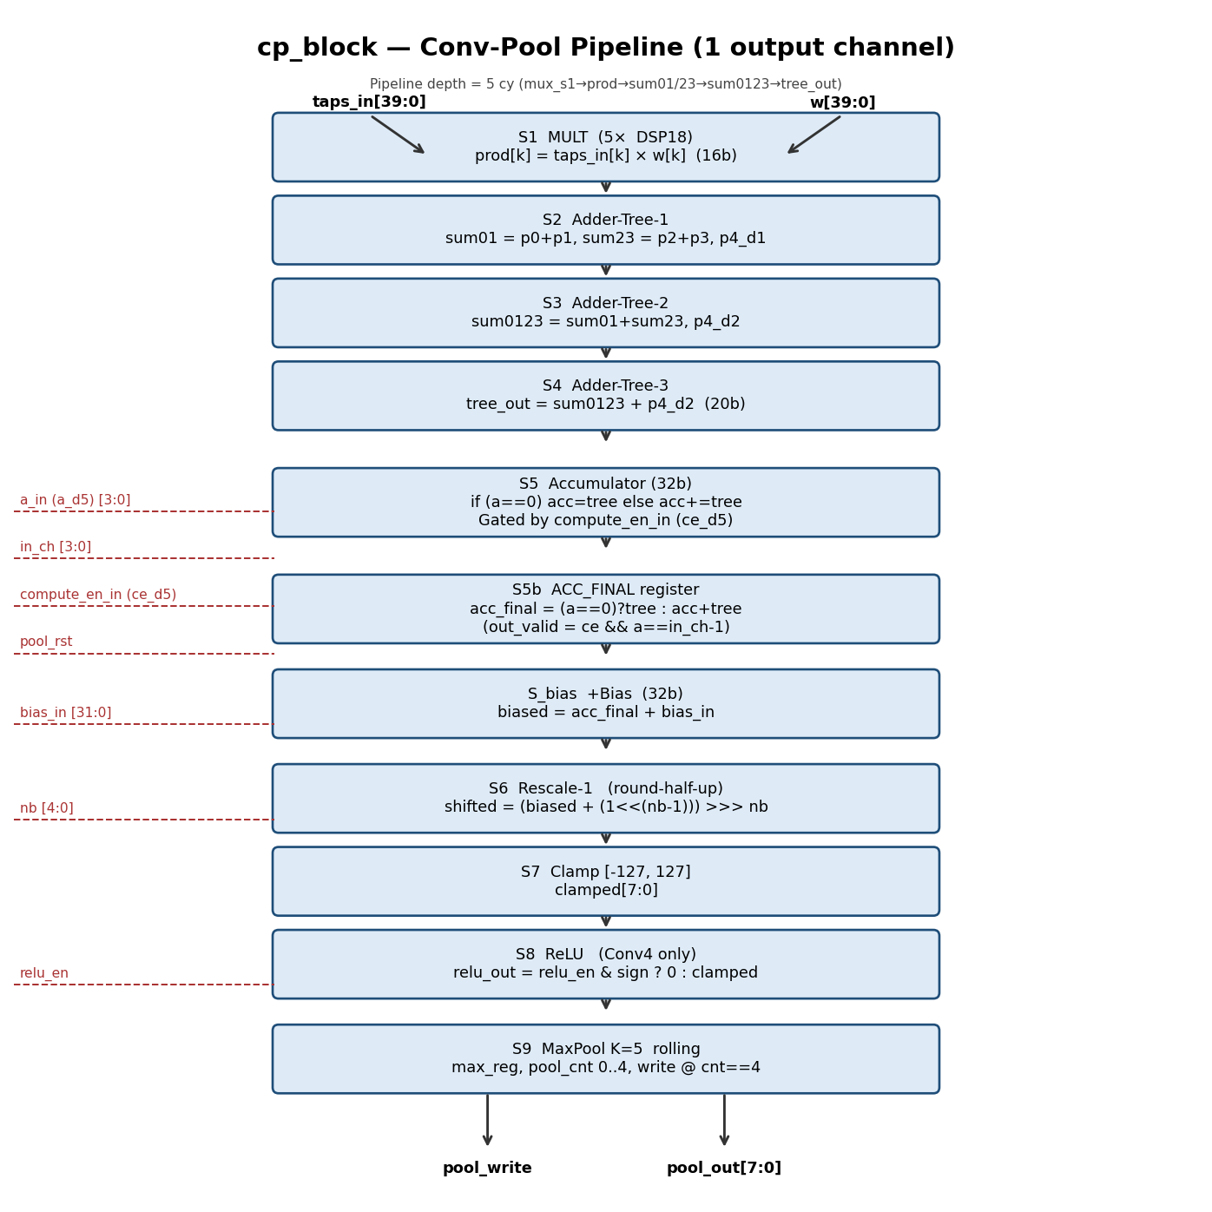
hardware/docs/diagrams/02_cp_block.png
