Haveroahl/1D-CNN-Accelerator-for-ECG-Arrhythmia-Classification-on-FPGA/hardware/docs/diagrams/03_cp_engine.png

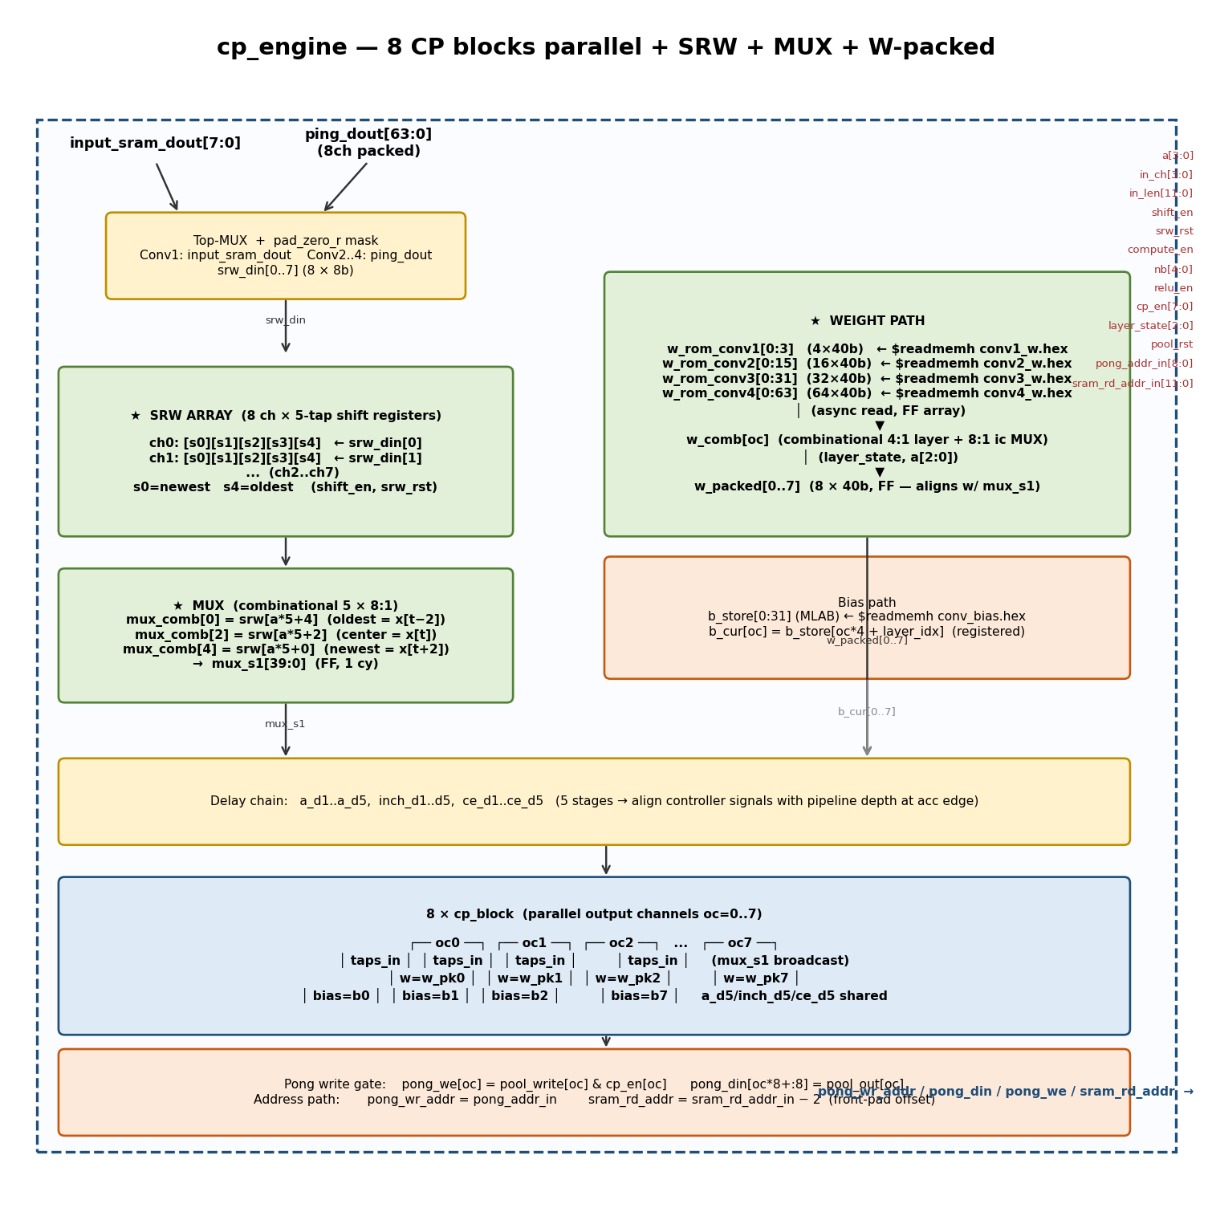
hardware/docs/diagrams/03_cp_engine.png
