Haveroahl/1D-CNN-Accelerator-for-ECG-Arrhythmia-Classification-on-FPGA/hardware/docs/diagrams/04_gap_fc_argmax.png

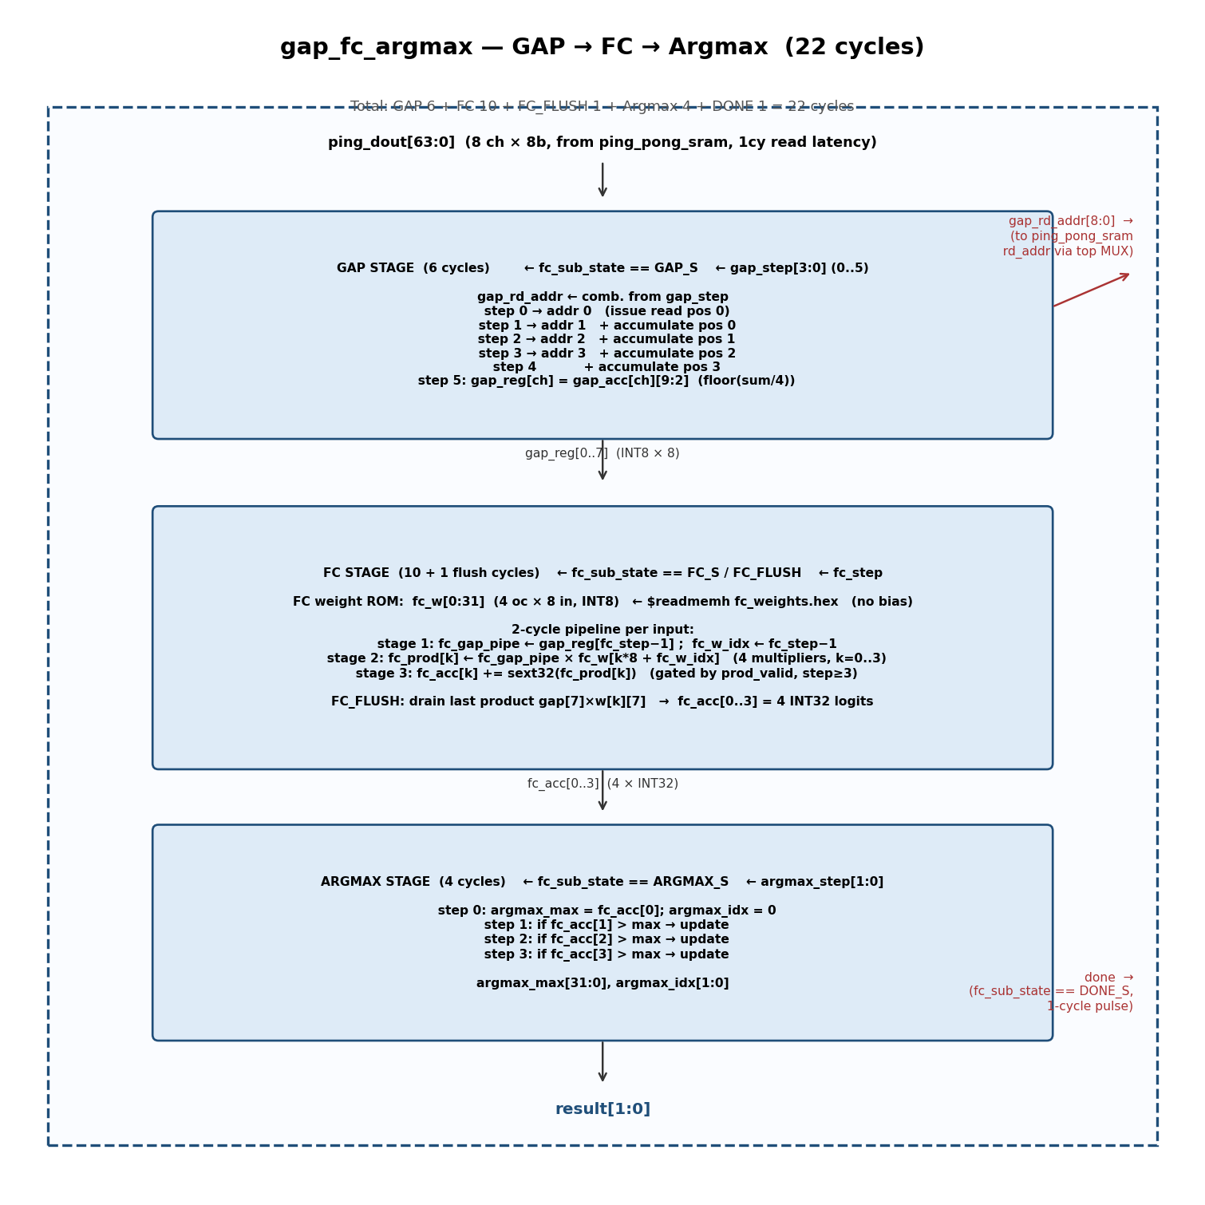
hardware/docs/diagrams/04_gap_fc_argmax.png
