Haveroahl/1D-CNN-Accelerator-for-ECG-Arrhythmia-Classification-on-FPGA/software/plots/dataset/plot1_class_distribution.png

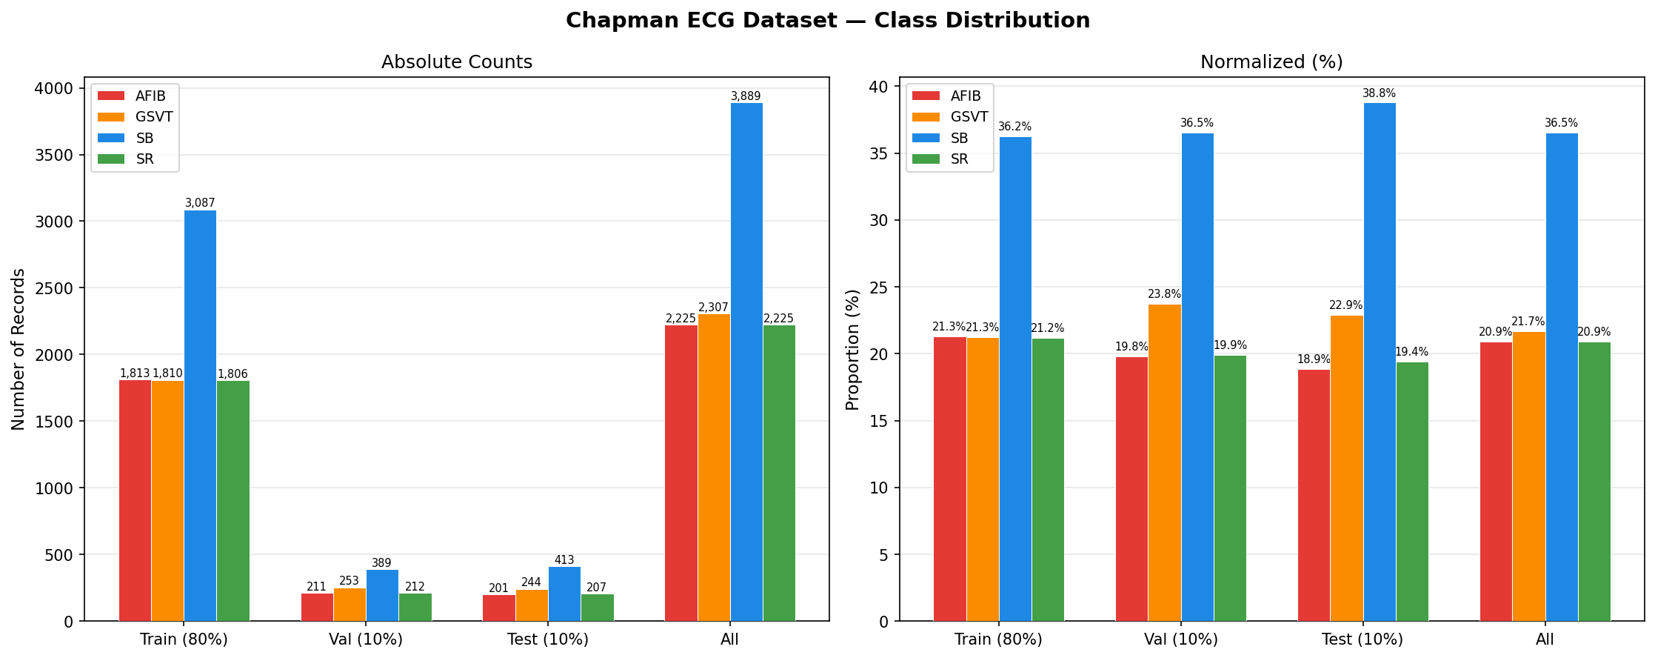
software/plots/dataset/plot1_class_distribution.png
