Haveroahl/1D-CNN-Accelerator-for-ECG-Arrhythmia-Classification-on-FPGA/software/plots/dataset/plot2_waveforms.png

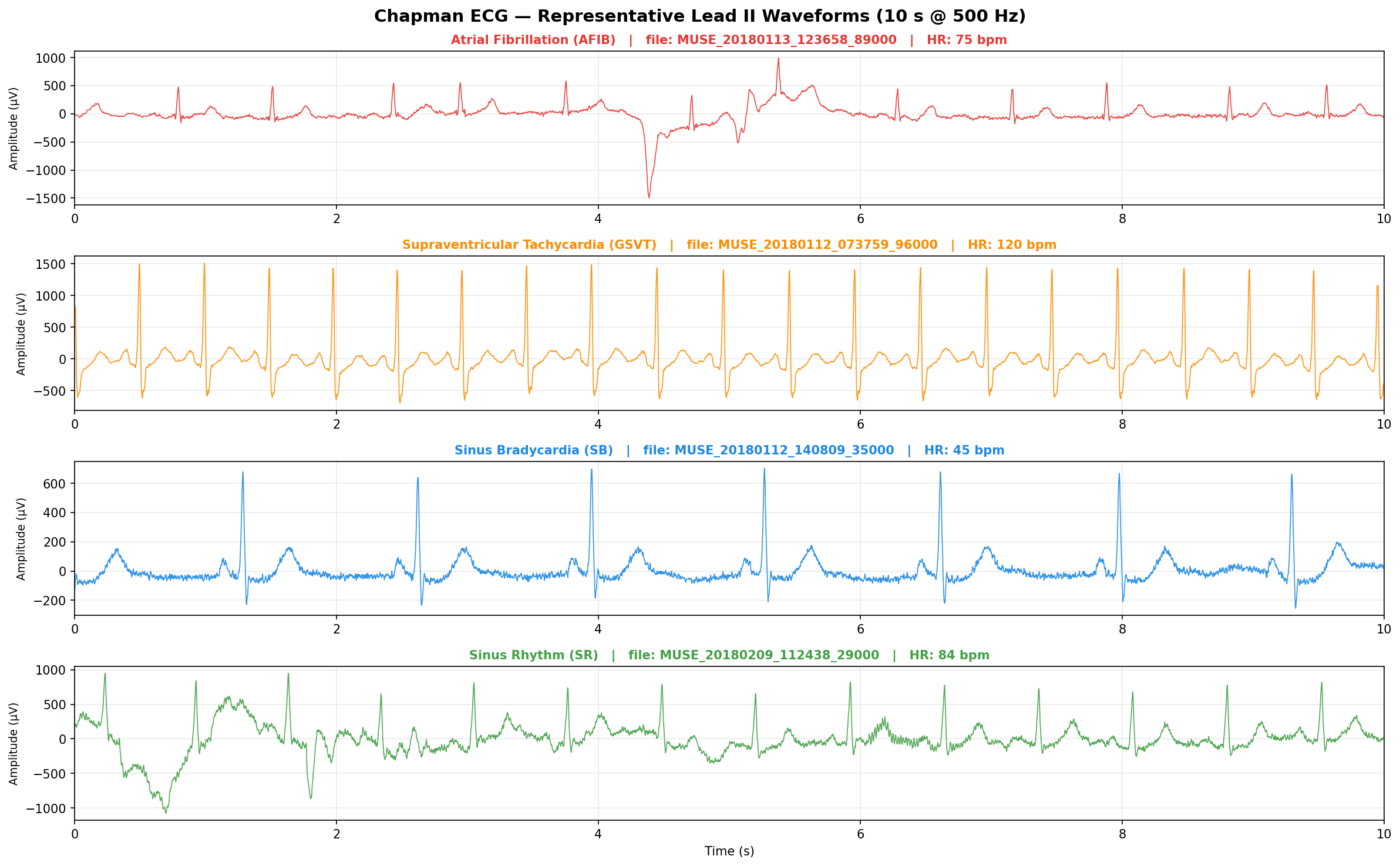
software/plots/dataset/plot2_waveforms.png
