Haveroahl/1D-CNN-Accelerator-for-ECG-Arrhythmia-Classification-on-FPGA/software/plots/dataset/plot3_heart_rate.png

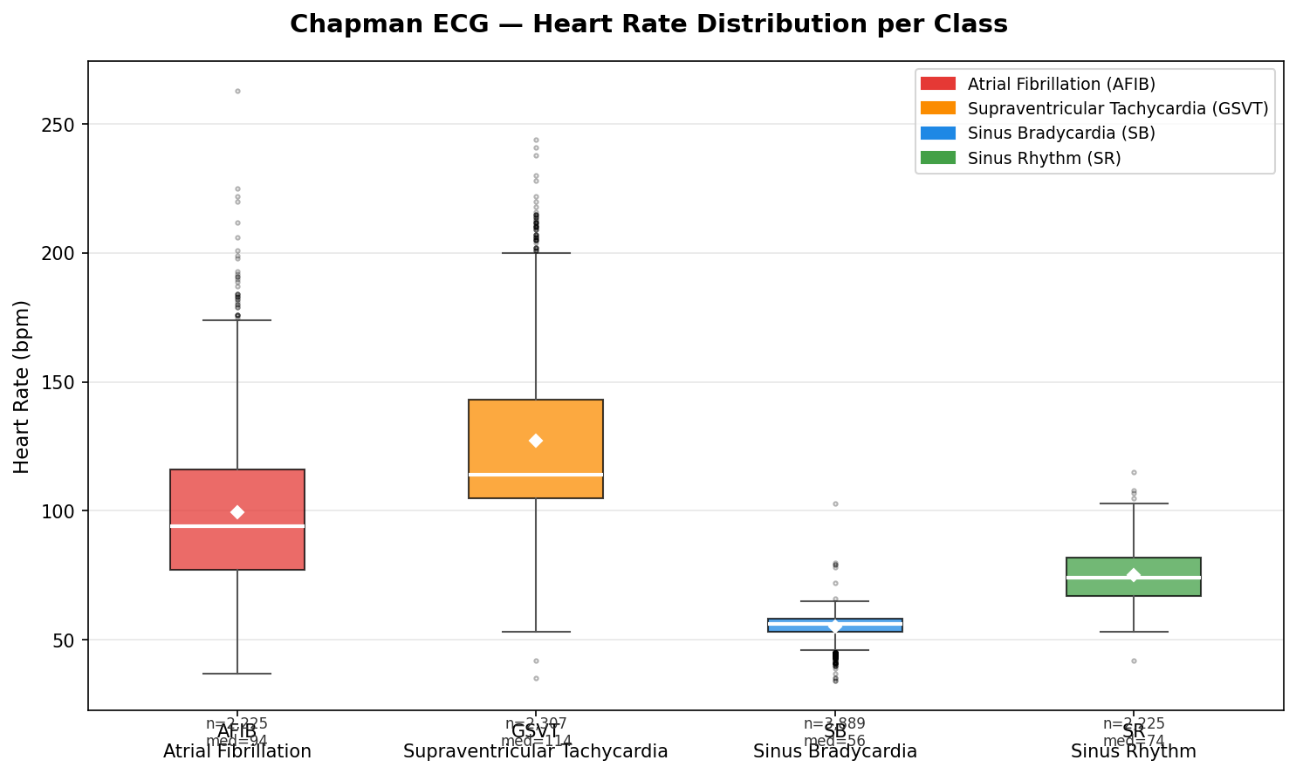
software/plots/dataset/plot3_heart_rate.png
