Haveroahl/1D-CNN-Accelerator-for-ECG-Arrhythmia-Classification-on-FPGA/software/plots/dataset/plot4_rhythm_mapping.png

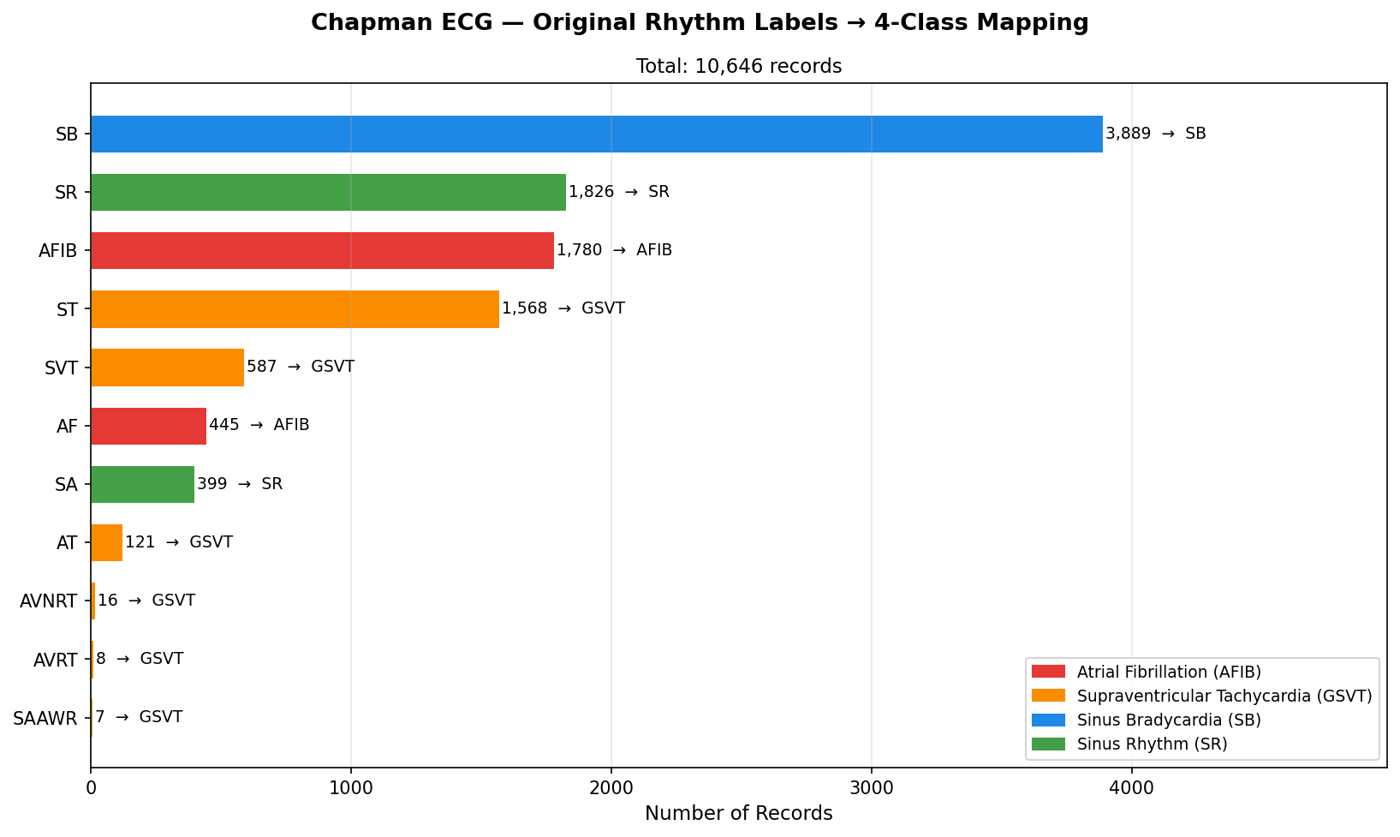
software/plots/dataset/plot4_rhythm_mapping.png
