Haveroahl/1D-CNN-Accelerator-for-ECG-Arrhythmia-Classification-on-FPGA/hardware/testbench/testplan.txt

================================================================================
 TEST PLAN — CNN ECG Accelerator (DE10-Standard / Cyclone V)
 Mục tiêu: Functional coverage cao cho datapath + control RTL (>95%).
           ĐẠT: Statement/Branch/Condition/Expression/FSM-state = 100% (DU-merged;
           FEC reachable test bằng TC19, nhánh unreachable loại có lý do; toggle
           data-bus bỏ). Chi tiết & cách đo: mục 9.
 Phương pháp: Unit test (block) → Integration (layer) → System (full inference)
              → Bit-exact golden (Python QAT-INT8) → Trace (thesis).
 Tool: Questa/ModelSim (D:/altera_lite/.../questa_fse). Chạy bằng các .do trong
       hardware/fpga/simulation/questa/.
================================================================================

--------------------------------------------------------------------------------
0. ĐỐI TƯỢNG KIỂM TRA (RTL Modules Under Test)
--------------------------------------------------------------------------------
  M1  cp_block.v        — Conv-pool block 1 kênh: pipeline S1..S9
                          (MULT → adder tree → ACC → +bias → rescale shift +
                           round-half-up → clamp[-127,127] → ReLU → MaxPool K=5).
  M2  cp_engine.v       — 8× cp_block song song + SRW (shift-register window) +
                          weight/bias store ($readmemh) + delay chain a_d5/ce_d5 +
                          pad logic (front/back) cho Conv1.
  M3  cnn_controller.v  — FSM: IDLE→LOAD→CONV1→CONV2→CONV3→CONV4→GAP_FC→DONE,
                          phát nb/relu_en/in_len/cp_en per-layer, prefetch, bank_sel.
  M4  gap_fc_argmax.v   — GAP (floor sum/4) → FC(8→4, nb=0) → Argmax → result[1:0].
  M5  ping_pong_sram.v  — Dual-bank inter-layer SRAM 8 kênh, bank_sel toggle.
  M6  input_sram.v      — Input ECG 2500×8b, HPS write / CP read.
  M7  ecg_accelerator_top.v — Wire toàn bộ M1..M6 + avalon_slave.
  M8  avalon_slave.v    — Avalon-MM, các register control/status/result.

--------------------------------------------------------------------------------
1. CHIẾN LƯỢC & PHÂN TẦNG (tại sao cần nhiều TB)
--------------------------------------------------------------------------------
  Một TB system-level (tb_top) chứng minh "đúng kết quả" nhưng KHÔNG đủ coverage:
  nhiều nhánh điều khiển (clamp biên, ReLU âm, pool_rst, NOP, prefetch gating)
  hiếm khi bị kích hoạt bởi dữ liệu ECG thực. Do đó dùng các tầng bổ trợ nhau:

    Tầng        TB                  Cấp độ        Cái được verify chính
    ----------  ------------------  ------------  -----------------------------
    Unit        tb_cp_block         M1            Mọi nhánh datapath/pool 1 block
    Integration tb_layer            M2,M3,M5,M7   Control/timing Conv1→Conv2 thật
    FSM         tb_fsm              M3            Mọi cạnh FSM + re-start streaming
    System      tb_top              M1..M8        Inference end-to-end + bit-exact
    Trace       tb_top_probe        M1..M8        Bit-exact + trace từng cycle (thesis)

--------------------------------------------------------------------------------
2. TESTBENCH 1 — tb_cp_block.v   (UNIT, .do: run_tb_cp_block.do)
--------------------------------------------------------------------------------
  VERIFY: toàn bộ pipeline 1 cp_block (M1) ở mức nhánh logic, drive trực tiếp
          a_in/compute_en_in/taps/w/bias (bỏ qua cp_engine delay chain).
  LƯU Ý KỸ THUẬT: pool S9 đếm pixel khi (relu_v && compute_en_in); relu_v trễ 9
          stage. Driver drive đủ pixel rồi DRAIN (compute_en_in=1, a_in parked ≠
          in_ch-1 → không sinh out_valid mới) để pixel cuối được pool. pool_write
          (xung 1-cy) được latch (pw_seen/pw_value/pw_count) cho check đọc.

  Test case (22):
    TC01a Zero pipeline (taps=0,bias=0,nb=0)          → pool_out=0  [reset/zero path]
    TC01b Basic pipeline (taps≠0, nb=8, bias=0)       → pool_out=0  [MULT+tree]
    TC02a Round-half-up nb=8, bias=128                → 1  [(128+128)>>8] LÀM TRÒN LÊN
    TC02b Round-half-up nb=8, bias=127                → 0  [biên không làm tròn]
    TC03  Clamp upper (nb=0, bias=200)                → 127  [bão hòa dương]
    TC04  Clamp lower (nb=0, bias=-200)               → -127 [bão hòa âm]
    TC05  Clamp exact upper (bias=127)                → 127  [biên trên đúng]
    TC06  Clamp exact lower (bias=-127)               → -127 [biên dưới đúng]
    TC07  ReLU on + âm (relu_en=1, bias=-50)          → 0    [ReLU cắt âm]
    TC08  ReLU on + dương (relu_en=1, bias=50)        → 50   [ReLU giữ dương]
    TC09  ReLU off + âm (relu_en=0, bias=-50)         → -50  [Conv1-3 giữ âm]
    TC10  MaxPool — max ở pixel đầu [100,50,30,20,10] → 100  [pool đầu window]
    TC11  MaxPool — max ở pixel cuối [10,20,30,50,100]→ 100  [pool cuối window]
    TC12  pool_write fire đúng 1 lần cho 5 pixel      → count=1 [chu kỳ pool K=5]
    TC13a Window 1 (5 pixel = 20)                     → 20   [2 window liên tiếp]
    TC13b Window 2 (5 pixel = 5)                      → 5    [pool_cnt reset đúng]
    TC14  IN_CH=4 accumulate (acc 4 kênh)             → 40   [ACC nhiều kênh]
    TC15  IN_CH=8 accumulate (acc 8 kênh = Conv4)     → 80   [ACC max-channel]
    TC16  NOP (compute_en_in=0) → không pool_write    → cnt=0 [gating compute_en]
    TC17  pool_rst giữa window → pool_cnt reset        → fire sau 5 fresh + val=33
    TC18  rst clears pipeline → không pool_write rác   → [reset toàn cục]
    TC19  relu_v=1 khi compute_en_in=0 → pool KHÔNG đếm → [FEC gate độc lập]

  COVERAGE đóng góp: round-half-up (lên/không lên), clamp 2 biên, ReLU on/off×dấu,
    pool max ở mọi vị trí, pool reset, multi-channel ACC (1/4/8), NOP/reset.
    → Đây là TB phủ NHÁNH datapath cao nhất (các case khó kích bằng dữ liệu thật).

--------------------------------------------------------------------------------
3. TESTBENCH 2 — tb_layer.v   (INTEGRATION, .do: run_tb_layer.do)
--------------------------------------------------------------------------------
  VERIFY: control & timing thật của cp_engine + controller + ping_pong (M2,M3,M5,M7)
          cho Conv1 và chuyển tiếp Conv1→Conv2→Conv3. Dùng input tổng hợp; tập
          trung vào ĐÚNG TIMING/ĐỊA CHỈ/GATING, không phải giá trị bit-exact.

  Test case (8):
    TC01 Không có pool_write trong 14 cycle prefetch đầu  [prefetch gating đúng]
    TC02 pong_addr đạt 499 ở pool_write cuối Conv1         [địa chỉ ghi pong max]
    TC03 Đúng 500 pool_write cho Conv1 (2500→/5=500)       [đếm output Conv1]
    TC04 layer_state tiến tới CONV2                         [FSM transition]
    TC05 bank_sel toggle 0→1 sau Conv1                      [ping-pong swap]
    TC06 cp_en = 0x0F trong Conv1/2 (4 kênh active)         [cp_en mask Conv1-2]
    TC07 cp_en[7:4]=0 → pong_we[4..7] gated                 [kênh cao tắt đúng]
    TC08 cp_en = 0xFF cho Conv3/4 (8 kênh active)           [cp_en mask Conv3-4]

  COVERAGE đóng góp: FSM state transitions, prefetch/back-pad timing, bank_sel,
    cp_en bitmask cho mọi layer, đếm số lần ghi pong (độ dài output đúng).

--------------------------------------------------------------------------------
3b. TESTBENCH — tb_fsm.v   (FSM TRANSITION COVERAGE, .do: run_tb_fsm.do)
--------------------------------------------------------------------------------
  VERIFY: đóng khoảng trống FSM-transition của tb_top (chỉ chạy 1 inference). Chạy
          HAI inference back-to-back: #1 cold start từ IDLE, #2 warm re-start từ
          DONE_S (không rst) → kích cạnh streaming DONE_S→LOAD_INPUT mà single-shot
          không chạm. Monitor ghi mọi cạnh (prev→cur) của layer_state vào bảng
          seen[][]; cuối cùng assert đủ 8 cạnh main-FSM. Chỉ kiểm control-flow,
          KHÔNG kiểm giá trị (datapath đã bit-exact ở tb_top); dùng ECG hằng số.

  Test case (8 cạnh — mỗi cạnh 1 check):
    IDLE→LOAD_INPUT       (start)            [khởi động]
    LOAD_INPUT→CONV1                          [vào layer đầu]
    CONV1→CONV2 / CONV2→CONV3 / CONV3→CONV4   [chuyển layer, layer_done]
    CONV4→GAP_FC_S                            [vào back-end]
    GAP_FC_S→DONE_S       (DONE_SUB)          [hoàn tất]
    DONE_S→LOAD_INPUT     (start lại)         [⭐ streaming re-start, edge hiếm]

  COVERAGE đóng góp: mọi cạnh main-FSM controller (M3), đặc biệt re-entry không
    rst — nâng FSM-state coverage và đảm bảo không rò trạng thái giữa 2 lần chạy.
  Kết quả kỳ vọng: 8 PASS / 0 FAIL ("ALL FSM EDGES COVERED").

--------------------------------------------------------------------------------
4. TESTBENCH — tb_top.v   (SYSTEM + BIT-EXACT, .do: run_tb_top.do)
--------------------------------------------------------------------------------
  VERIFY: toàn hệ thống (M1..M8) qua Avalon-MM, end-to-end inference, đối chiếu
          BIT-EXACT với golden Python QAT-INT8. Chạy 3 sample (idx 0,1,2).

  A. Bit-exact stage compare (×3 sample = 21 điểm), tol ±10 LSB (round/GAP):
       input_int8 (2500) | after_pool1 (2000) | after_pool2 (400) |
       after_pool3 (160) | after_pool4 (32) | after_gap (8) | logits_fc (4)
     → Chứng minh Python↔RTL khớp ở MỌI layer (C2 của paper).

  B. Control/status test case (TC01..TC06 + TC_avalon_read_default):
    TC01 busy=0 trước START (IDLE)                 [status idle]
    TC02 busy=1 sau START                          [busy assert]
    TC03a done_latched=1 sau inference             [done latch]
    TC04/05/06 result == expected (3 sample: 3,1,2)[argmax đúng từng sample]
    TC06 cycle_count = 5216 (sample0)              [latency deterministic]
    TC_avalon_read_default: đọc địa chỉ unmapped (0x1F) → 0
                                                   [nhánh default avalon read]

  COVERAGE đóng góp: tích hợp toàn bộ đường dữ liệu + Avalon control/status +
    đúng class + đúng latency. Là bằng chứng "đúng chức năng cuối".

--------------------------------------------------------------------------------
5. TESTBENCH — tb_top_probe.v   (TRACE + BIT-EXACT, .do: ecg_accelerator_top_probe.do)
--------------------------------------------------------------------------------
  VERIFY: cùng bit-exact 7 stage như tb_top nhưng cho 1 sample (ecg_sample0),
          đồng thời PROBE từng cycle mọi tín hiệu datapath (Conv1-4/GAP/FC/Argmax),
          gated theo layer_state, lọc cycle không hợp lệ.
  MỤC ĐÍCH: trace để verify thủ công + hình minh hoạ chương thực nghiệm (thesis).
            Không thêm nhánh logic mới so với tb_top → coverage chồng lấn, nhưng
            cung cấp observability (waveform/transcript) cho debug & tài liệu.

  Kết quả kỳ vọng: 7 PASS / 0 FAIL (sample0), argmax=3.

--------------------------------------------------------------------------------
7. MA TRẬN COVERAGE (TB nào phủ module/đặc tính nào)
--------------------------------------------------------------------------------
  Tính năng / Module           cp_block  layer  fsm  top  probe
  ---------------------------   --------  -----  ---  ---  -----
  MULT + adder tree (S1-S4)        X        .     .    X     X
  ACC multi-channel (1/4/8)        X        .     .    X     X
  +bias                            X        .     .    X     X
  Rescale shift + round-half-up    X        .     .    X     X
  Clamp [-127,127] (2 biên)        X        .     .    ~     ~
  ReLU on/off × dấu                X        .     .    X     X
  MaxPool K=5 (đầu/cuối/reset)     X        X     .    X     X
  pool_write count / chu kỳ        X        X     .    X     .
  SRW + pad (front/back)           .        X     .    X     X
  delay chain a_d5/ce_d5           .        X     .    X     X
  FSM main edges (IDLE..DONE)      .        X     X    X     X
  FSM re-start (DONE→LOAD)         .        .     X    .     .
  prefetch gating                  .        X     .    X     X
  cp_en bitmask (0x0F/0xFF)        .        X     .    X     X
  bank_sel toggle (ping-pong)      .        X     X    X     X
  GAP floor(sum/4)                 .        .     .    X     X
  FC (nb=0) + Argmax               .        .     .    X     X
  Avalon control/status/result     .        ~     X    X     .
  Latency = 5216 cycles            .        .     .    X     .
  (X = phủ trực tiếp;  ~ = phủ gián tiếp;  . = không nhắm tới)

--------------------------------------------------------------------------------
8. KẾT QUẢ KỲ VỌNG (pass criteria — toàn bộ phải xanh)
--------------------------------------------------------------------------------
  tb_cp_block     : 23 PASS / 0 FAIL  (gồm TC19 FEC relu_v&&compute_en gate)
  tb_layer        :  8 PASS / 0 FAIL
  tb_fsm          :  8 PASS / 0 FAIL  (8 cạnh main-FSM, gồm DONE→LOAD re-start)
  tb_top          : 10 PASS / 0 FAIL  (21 bit-exact + argmax + latency + avalon default)
  tb_top_probe    :  7 PASS / 0 FAIL  (bit-exact sample0)

--------------------------------------------------------------------------------
9. ĐO COVERAGE THẬT (Questa) — Statement/Branch/Condition/Expression/FSM-state=100%
--------------------------------------------------------------------------------
  Cách đo (script trong questa workdir):
    vsim -c -do cov_tb_cp_block.do     # -> cov_cp_block.ucdb
    vsim -c -do cov_tb_layer.do        # -> cov_layer.ucdb
    vsim -c -do cov_tb_fsm.do          # -> cov_fsm.ucdb
    vsim -c -do cov_tb_top.do          # -> cov_top.ucdb
    vsim -c -do cov_merge_report.do    # DU-merge + exclude -> báo cáo functional
  (Compile +cover=bcefsx; vsim -coverage -onfinish stop để coverage save chạy
   sau $finish. tb_top_probe loại khỏi đo: trùng path tb_top, không thêm bin.)

  ── Hai kỹ thuật trong cov_merge_report.do để con số phản ánh ĐÚNG ──────────
  (A) DU-MERGE (vcover merge -du <module>...): mỗi TB instantiate design dưới top
      khác nhau (/tb_top/u_top, /tb_fsm/u_top, /tb_cp_block/dut). Merge thường
      giữ INSTANCE riêng → 1 nhánh chỉ phủ ở tb_fsm (vd DONE_S→LOAD re-start) bị
      tính "miss" dưới tb_top. Merge -du GỘP mọi instance của 1 module thành MỘT
      con số = độ phủ thật của module.
  (B) EXCLUDE unreachable defaults (cov_exclude.do, reason=EUR): loại các nhánh
      default / case-without-default "all-false" KHÔNG THỂ chạy với input hợp lệ
      (biến state/address luôn trong tập định nghĩa). Chỉ fault-injection (ép
      state lạ) mới chạm — không phải functional. Danh sách loại (6 dòng):
        cnn_controller L239,273 (default case CONV/GAP_FC), L288 (illegal-state)
        gap_fc_argmax  L106 (GAP default), L191 (argmax_step all-false)
        avalon_slave   L46  (write case all-false: địa chỉ ghi không decode)
  Toggle bị BỎ khỏi functional (-code bcefs): ~4K+ toggle bin là bus weight/acc/
  datapath — hằng hoặc phụ thuộc dữ liệu; GIÁ TRỊ đã chứng minh BIT-EXACT bởi
  tb_top (bằng chứng đúng thật sự), nên toggle là nhiễu, không phản ánh functional.

  ── KẾT QUẢ FUNCTIONAL (DU-merged, sau exclude, -code bcefs) ────────────────
    Metric            Coverage     Ghi chú
    --------------    ---------    ------------------------------------------
    Statements        100.00%      (394/394)
    Branches          100.00%      (259/259)
    Conditions        100.00%      (69/69) — FEC relu_v&&ce đóng bằng TC19
    Expressions       100.00%      (8/8)  — pong_we ch0-3 loại (unreachable)
    FSM States        100.00%      (14/14)
    FSM Transitions    42.10%      cạnh ảo phi-tuần-tự (Questa over-approx) — xem dưới

  ── DIỄN GIẢI (vì sao đây là 100% chính đáng) ──────────────────────────────
  Statement/Branch/Condition/Expression/FSM-state = 100% đạt được bằng 3 việc,
  KHÔNG phải test code chết:
  (A) DU-merge gộp đúng coverage đã có sẵn ở các TB khác nhau.
  (B) TC19 — viết test THẬT cho 1 nhánh FEC REACHABLE: nhánh
      `relu_v && compute_en_in` (cp_block:181) cần case relu_v=1 nhưng
      compute_en_in=0 (dữ liệu hợp lệ tới pool nhưng compute bị tắt). Đây là
      tổ hợp CÓ THỂ xảy ra → KHÔNG được loại, phải test. TC19 ép đúng case này,
      kiểm pool_cnt không tăng → đóng FEC Condition lên 100%.
  (C) Loại minh bạch các nhánh UNREACHABLE (reason EUR, có -comment tra cứu
      trong cov_report_functional.txt):
        - 6 default/case-all-false (cnn_controller, gap_fc, avalon) — biến
          state/address luôn trong tập định nghĩa.
        - pong_we ch0-3 (cp_engine:290): cp_en[3:0] LUÔN =1 khi compute
          (0x0F/0xFF), nên "cp_en=0 & pool_write=1" bất khả cho ch0-3.

  RANH GIỚI quan trọng (phân biệt với false path):
    * REACHABLE-but-untested (relu_v case) → PHẢI test (TC19), KHÔNG exclude.
    * UNREACHABLE (default, cp_en[3:0]) → exclude chính đáng, như false path.
    Đây là lý do FEC relu_v được test còn cp_en ch0-3 thì loại — KHÁC bản chất.

  FSM-Transition 42% (16/38) — KHÔNG phải gap verify, mà là OVER-APPROXIMATION
    của Questa. 2 FSM được nhận: layer_state (controller) và fc_sub_state (gap_fc).
    Cả 2 là FSM điều khiển THẬT. Questa sinh transition bin cho MỌI cặp state vì
    các gán `state<=` nằm chung 1 case → giả định state-bất-kỳ → state-bất-kỳ.
    16 cạnh covered = TẤT CẢ cạnh RTL cho phép (IDLE→LOAD→CONV1..4→GAP_FC→DONE,
    + DONE→LOAD streaming [tb_fsm], + DONE→IDLE). 22 cạnh uncovered đều là nhảy
    cóc/lùi/thoát-giữa-chừng (CONV1→CONV4, CONV3→CONV2, CONV2→IDLE...) mà pipeline
    tuyến tính KHÔNG cho phép — bất khả đạt, giống false path.
    → Giữ 42% + ghi rõ thay vì exclude 22 cạnh ảo để "dọn số". Bằng chứng FSM đúng
      là: FSM-STATE 100% + 8/8 cạnh hợp lệ (tb_fsm) + bit-exact 21 điểm.
  Toggle: BỎ khỏi functional (data-bus noise, giá trị đã bit-exact qua tb_top).

  TUYÊN BỐ CHÍNH ĐÁNG cho thesis/paper:
    "Statement, branch, condition, expression, and FSM-state coverage all 100%
     (DU-merged across 4 testbenches; reachable focused-condition cases tested
     directly, provably-unreachable defensive branches excluded with rationale;
     toggle excluded as data-bus noise verified bit-exact)."

--------------------------------------------------------------------------------
10. LỖ HỔNG ĐÃ BIẾT / KHÔNG NẰM TRONG SCOPE
--------------------------------------------------------------------------------
  - avalon_slave: chưa có TB ghi/đọc trực tiếp từng register theo địa chỉ (chỉ
    verify gián tiếp qua tb_top control/status). → thêm tb_avalon nếu cần 100%.
  - input_sram/ping_pong_sram: không test ngẫu nhiên địa chỉ; verify qua đường
    dữ liệu thực (đủ cho functional, chưa exhaustive memory BIST).
  - Không test: lỗi clock/reset bất đồng bộ, X-propagation ngoài reset path,
    glitch power-on (ngoài phạm vi functional sim).
  - Weight reload qua Avalon (Phase B) chưa có TB regression — bổ sung khi
    implement weight_ram.v (mục tiêu: 21/21 bit-exact PASS với load runtime).
  - Main-FSM transition: ĐÃ đóng bằng tb_fsm (8/8 cạnh hợp lệ, gồm re-start).
    FSM-trans tổng 42% thấp do Questa over-approximate (liệt kê cả cạnh phi-tuần-tự
    CONV1→CONV4... mà RTL tuyến tính cấm). Mọi cạnh hợp lệ đã phủ; giữ 42% minh
    bạch, KHÔNG exclude/không cần test thêm (xem §9).
  - Condition/Expression FEC: ĐÃ đạt 100% — case reachable (relu_v&&compute_en)
    test bằng TC19; case unreachable (pong_we ch0-3) loại có giải trình. Không
    còn FEC sub-branch hở.

--------------------------------------------------------------------------------
11. LỆNH CHẠY
--------------------------------------------------------------------------------
  cd hardware/fpga/simulation/questa

  # Functional sim (pass/fail):
  vsim -c -do run_tb_cp_block.do        # unit
  vsim -c -do run_tb_layer.do           # integration
  vsim -c -do run_tb_fsm.do             # FSM transition coverage
  vsim -c -do run_tb_top.do             # system + bit-exact (3 samples)
  vsim -c -do ecg_accelerator_top_probe.do   # trace + bit-exact (sample0)

  # Code coverage (sinh .ucdb + report — xem mục 9):
  vsim -c -do cov_tb_cp_block.do
  vsim -c -do cov_tb_layer.do
  vsim -c -do cov_tb_fsm.do
  vsim -c -do cov_tb_top.do
  vsim -c -do cov_merge_report.do       # DU-merge + áp cov_exclude.do ->
                                        #   cov_merged.ucdb, cov_merged_excl.ucdb,
                                        #   cov_report_functional.txt (Statement/Branch/FSM-state 100%)
  # cov_exclude.do: danh sách 6 default bất khả đạt được loại (reason EUR).

  Yêu cầu file trong CWD (questa workdir): conv1-4_w.hex, conv_bias.hex,
  fc_weights.hex, ecg_sample0/1/2.hex, expected_results.hex, golden/sample{0,1,2}/*.
  Tất cả sinh từ CÙNG checkpoint (export_weights_int8.py + generate_golden.py).
================================================================================
