Haveroahl/1D-CNN-Accelerator-for-ECG-Arrhythmia-Classification-on-FPGA/software/python/results/train_log.csv

epoch | train_loss | train_acc | val_loss | val_acc | val_f1 | lr | time_s | is_best
1 | 1.181310 | 0.413471 | 0.933628 | 0.610329 | 0.529966 | 1.0e-03 | 1.4 | 1
2 | 0.637963 | 0.758641 | 0.523998 | 0.804695 | 0.766912 | 1.0e-03 | 0.5 | 1
3 | 0.449888 | 0.825402 | 0.429782 | 0.827230 | 0.795026 | 1.0e-03 | 0.5 | 1
4 | 0.393626 | 0.856061 | 0.389147 | 0.864789 | 0.847167 | 1.0e-03 | 0.5 | 1
5 | 0.349935 | 0.876065 | 0.351280 | 0.865728 | 0.847742 | 1.0e-03 | 0.5 | 1
6 | 0.330593 | 0.885180 | 0.333202 | 0.881690 | 0.868310 | 1.0e-03 | 0.5 | 1
7 | 0.311263 | 0.895360 | 0.319421 | 0.892958 | 0.884185 | 1.0e-03 | 0.5 | 1
8 | 0.296183 | 0.898438 | 0.305658 | 0.891080 | 0.879711 | 1.0e-03 | 0.5 | 1
9 | 0.283983 | 0.906487 | 0.282179 | 0.908920 | 0.899997 | 1.0e-03 | 0.4 | 1
10 | 0.270421 | 0.913116 | 0.275919 | 0.907042 | 0.898823 | 1.0e-03 | 0.5 | 1
11 | 0.261921 | 0.912050 | 0.261568 | 0.911737 | 0.903856 | 1.0e-03 | 0.5 | 1
12 | 0.249603 | 0.918797 | 0.259271 | 0.903286 | 0.894132 | 1.0e-03 | 0.5 | 1
13 | 0.238180 | 0.921757 | 0.259548 | 0.911737 | 0.904049 | 1.0e-03 | 0.4 | 0
14 | 0.236644 | 0.921638 | 0.243984 | 0.911737 | 0.903691 | 1.0e-03 | 0.4 | 1
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
