Haveroahl/1D-CNN-Accelerator-for-ECG-Arrhythmia-Classification-on-FPGA/hardware/testbench/ecg_samples_plot.png

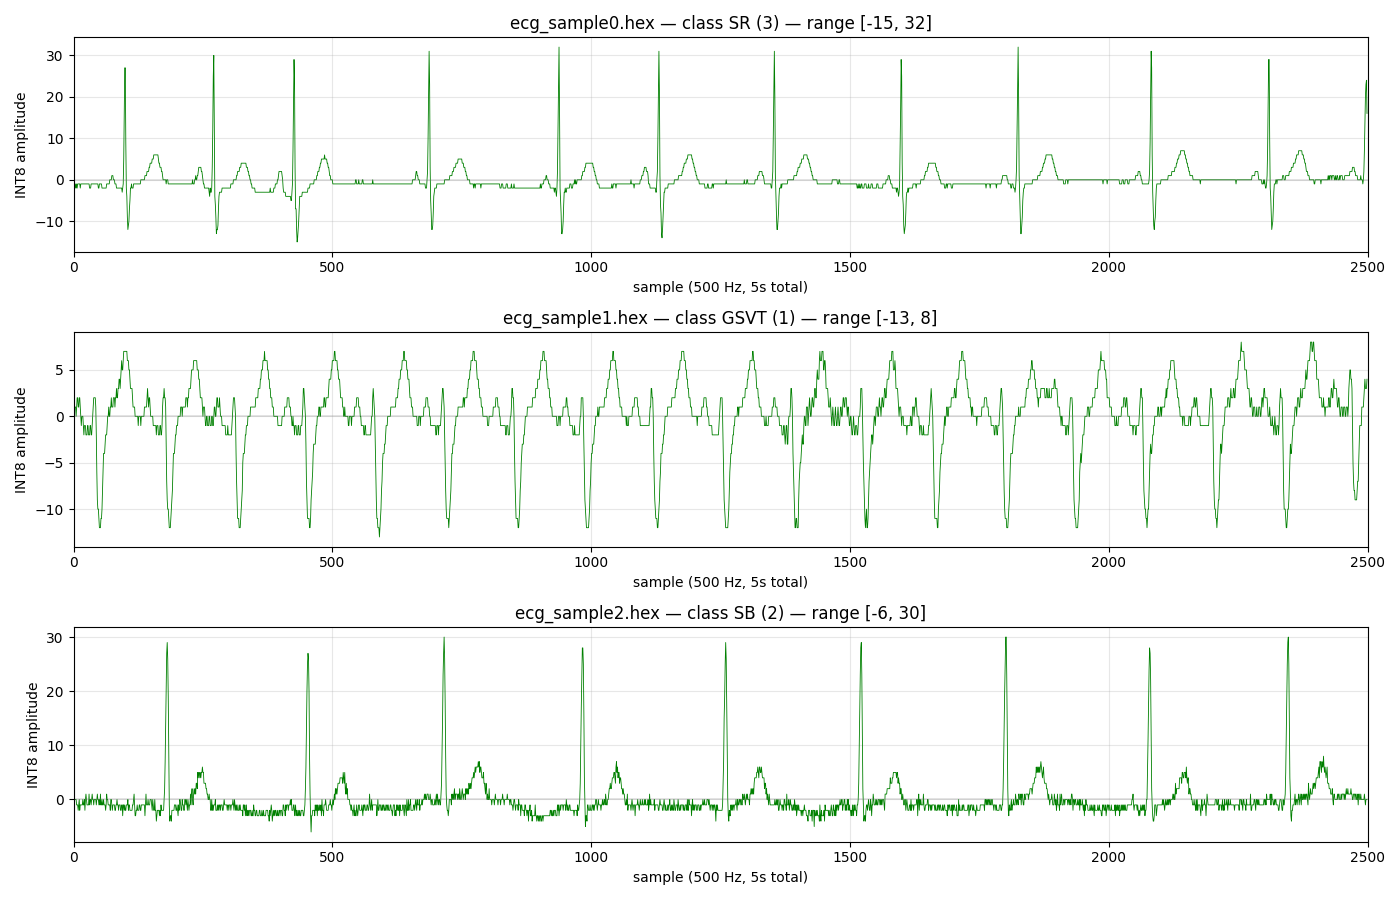
hardware/testbench/ecg_samples_plot.png
