Haveroahl/1D-CNN-Accelerator-for-ECG-Arrhythmia-Classification-on-FPGA/software/python/results/figures/chapman_confusion_matrix.png

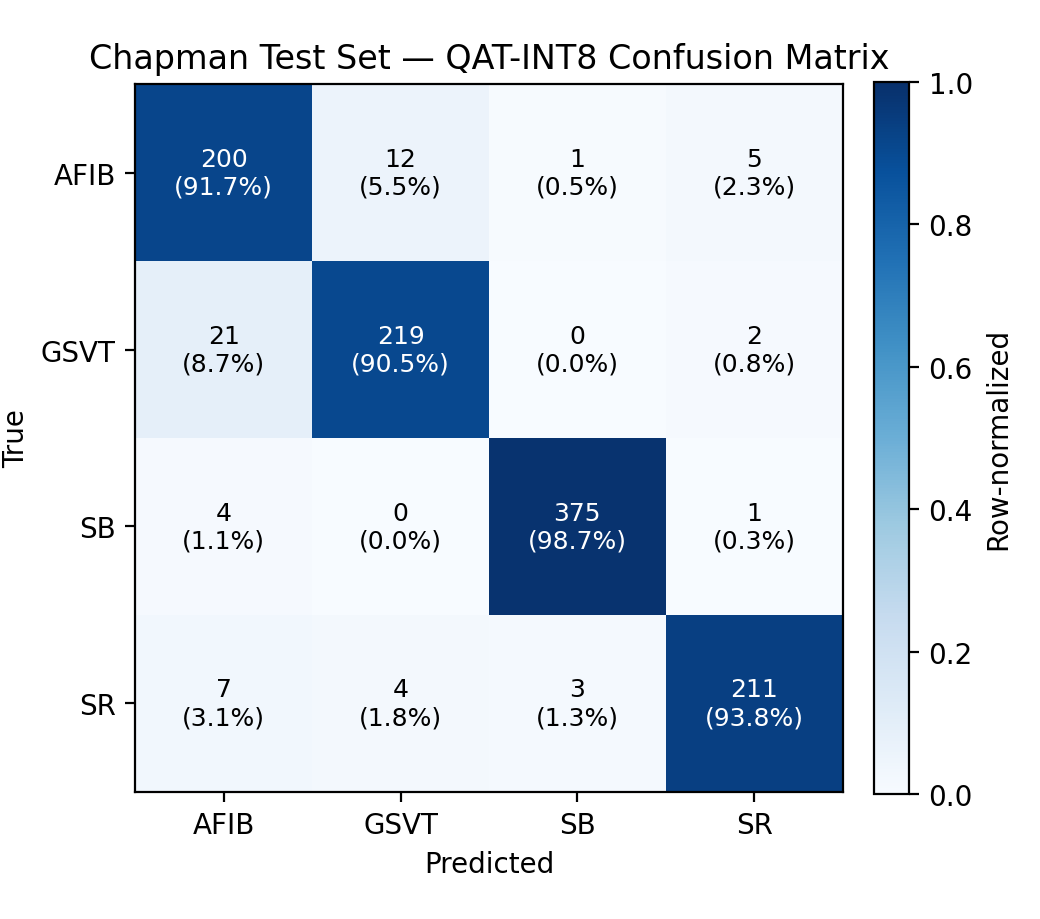
software/python/results/figures/chapman_confusion_matrix.png
