Haveroahl/1D-CNN-Accelerator-for-ECG-Arrhythmia-Classification-on-FPGA/software/python/results/figures/chapman_roc.png

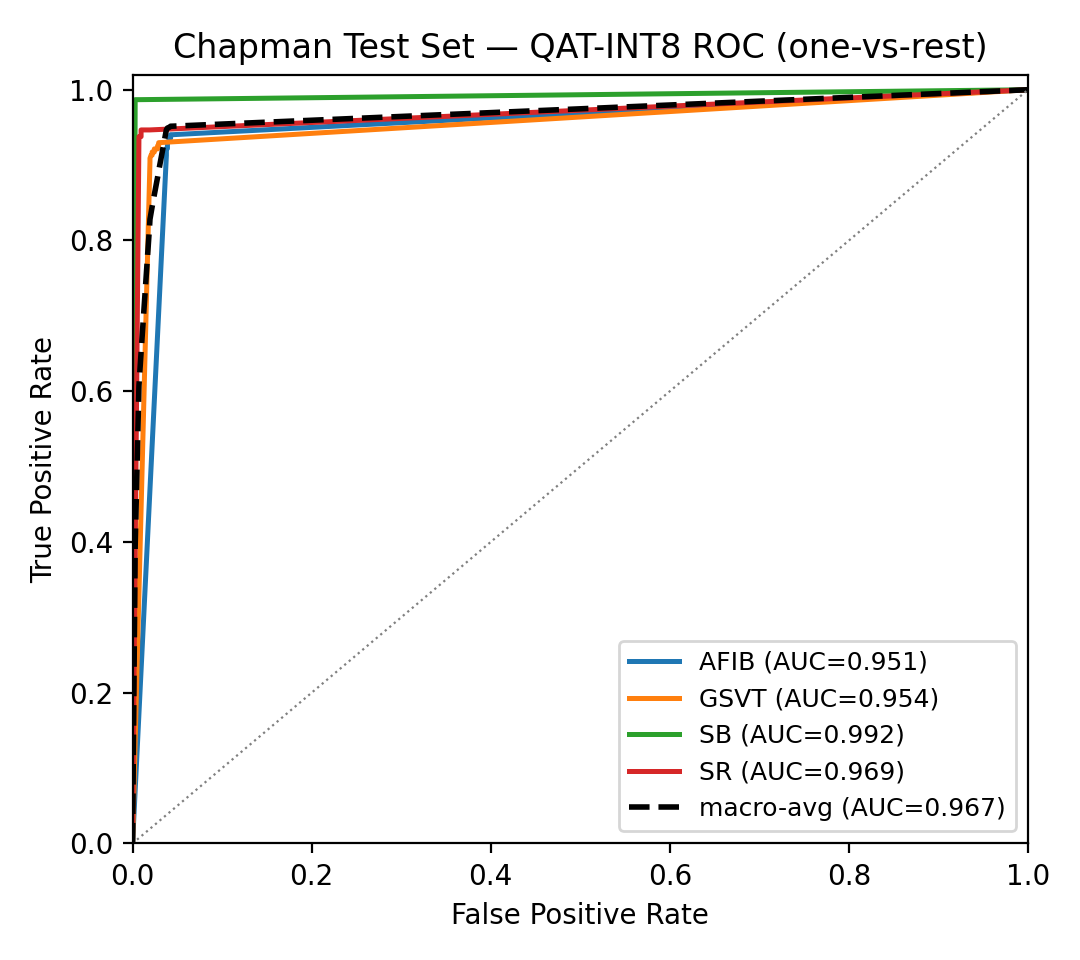
software/python/results/figures/chapman_roc.png
