Haveroahl/1D-CNN-Accelerator-for-ECG-Arrhythmia-Classification-on-FPGA/hardware/testbench/tb_layer.v

// tb_layer.v — Conv1 integration test
// DUT: ecg_accelerator_top (all modules, but only Conv1 execution observed)
//
// Tests:
//   TC01 — Pre-fetch: no pool_write in first 15 cycles after START
//   TC02 — pong_addr increments on each pool_write
//   TC03 — Exactly 500 pool_writes for Conv1 (OUT_LEN=500)
//   TC04 — layer_state transitions IDLE→LOAD→CONV1→CONV2 after Conv1 done
//   TC05 — bank_sel toggles 0→1 at Conv1→CONV2 transition
//   TC06 — cp_en=0x0F during Conv1 (pong_we[4..7]=0)
//   TC07 — pong_we[0..3]=1 during pool_write (active channels)
//   TC08 — srw_rst=1 exactly 1 cycle at CONV1→CONV2 transition
//
// Requires: conv_weights.hex, conv_bias.hex in RTL/ (uses zero weights if missing)
// Note: tb uses hierarchical references to monitor internal signals

`timescale 1ns/1ps

module tb_layer;

    // ── DUT signals ───────────────────────────────────────────────────
    reg        clk, rst, rst_n;
    reg [4:0]  avs_address;
    reg        avs_write, avs_read;
    reg [31:0] avs_writedata;
    wire [31:0] avs_readdata;

    ecg_accelerator_top u_top (
        .clk         (clk),
        .rst         (rst),
        .rst_n       (rst_n),
        .avs_address (avs_address),
        .avs_write   (avs_write),
        .avs_read    (avs_read),
        .avs_writedata(avs_writedata),
        .avs_readdata(avs_readdata)
    );

    // ── Hierarchical signal aliases (ModelSim hierarchical reference) ──
    // Use wire assignments to bring internal signals to testbench scope
    wire [2:0]  layer_state  = u_top.u_core.ctrl_layer_state;
    wire        bank_sel     = u_top.u_core.ctrl_bank_sel;
    wire        pool_write   = u_top.u_core.cp_pool_write;
    wire [11:0] pong_addr    = u_top.u_core.ctrl_pong_addr;
    wire [7:0]  cp_en        = u_top.u_core.ctrl_cp_en;
    wire [7:0]  cp_pong_we   = u_top.u_core.cp_pong_we;
    wire        srw_rst      = u_top.u_core.ctrl_srw_rst;
    wire        compute_en   = u_top.u_core.ctrl_compute_en;

    // Layer state encoding (from cnn_controller.v)
    localparam IDLE       = 3'd0;
    localparam LOAD_INPUT = 3'd1;
    localparam CONV1      = 3'd2;
    localparam CONV2      = 3'd3;

    // ── Clock ─────────────────────────────────────────────────────────
    initial clk = 0;
    always #5 clk = ~clk;

    integer pass_cnt, fail_cnt;
    time    tc_t0;

    // ── Avalon-MM write helper ─────────────────────────────────────────
    task avs_wr;
        input [4:0]  addr;
        input [31:0] data;
        begin
            @(negedge clk);
            avs_address   = addr;
            avs_writedata = data;
            avs_write     = 1;
            @(posedge clk); #1;
            avs_write = 0;
        end
    endtask

    // Load 2500 ECG samples via Avalon-MM (DATA_IN=0x00, ADDR_IN=0x01, WR_EN=0x02)
    task load_ecg;
        input [7:0] sample_val;   // constant pattern for simplicity
        integer i;
        begin
            for (i = 0; i < 2500; i = i + 1) begin
                avs_wr(5'h00, {24'h0, sample_val});  // DATA_IN
                avs_wr(5'h01, i[31:0]);               // ADDR_IN
                avs_wr(5'h02, 32'd1);                 // WR_EN
            end
        end
    endtask

    // Load ECG from hex file
    task load_ecg_from_file;
        input [127*8-1:0] filename;
        reg [7:0] ecg_data [0:2499];
        integer i;
        begin
            $readmemh(filename, ecg_data);
            for (i = 0; i < 2500; i = i + 1) begin
                avs_wr(5'h00, {24'h0, ecg_data[i]});
                avs_wr(5'h01, i[31:0]);
                avs_wr(5'h02, 32'd1);
            end
        end
    endtask

    // Start inference
    task start_inference;
        begin
            avs_wr(5'h03, 32'd1);  // START
        end
    endtask

    // Wait for layer_state to reach target, with timeout
    task wait_for_state;
        input [2:0] target;
        input integer timeout_cycles;
        output reg success;
        integer t;
        begin
            success = 0;
            for (t = 0; t < timeout_cycles && !success; t = t + 1) begin
                @(posedge clk); #1;
                if (layer_state === target) success = 1;
            end
        end
    endtask

    // Count pool_write pulses over N cycles
    task count_pool_writes;
        input integer n_cycles;
        output integer count;
        integer i;
        begin
            count = 0;
            for (i = 0; i < n_cycles; i = i + 1) begin
                @(posedge clk); #1;
                if (pool_write) count = count + 1;
            end
        end
    endtask

    // ── Main test sequence ─────────────────────────────────────────────
    reg success;
    integer pw_count;
    integer t;

    initial begin
        pass_cnt = 0; fail_cnt = 0;
        avs_write = 0; avs_read = 0; avs_address = 0; avs_writedata = 0;

        $display("=== tb_layer: Conv1 integration test ===");

        // Reset
        rst = 1; rst_n = 0;
        @(posedge clk); @(posedge clk); #1;
        rst = 0; rst_n = 1;
        @(posedge clk); #1;

        // Load ECG (constant value=10 for all 2500 samples)
        $display("[setup] Loading 2500 ECG samples (val=10)...");
        load_ecg(8'd10);
        $display("[setup] Done loading.");

        // Start inference
        start_inference;
        tc_t0 = $time;

        // ── TC01: No pool_write in first 14 cycles after START ─────────
        // compute_en=1 từ LOAD_INPUT. Pipeline latency ≈11cy (mux+wpacked+mult+tree×3+
        // acc_final+bias+rescale×2+relu) + pool 5 relu_v → first pool_write ~15-16cy.
        // Verify no pool_write in first 14 cycles (safe margin).
        begin : tc01
            integer pw01, i01;
            pw01 = 0;
            for (i01 = 0; i01 < 14; i01 = i01 + 1) begin
                @(posedge clk); #1;
                if (pool_write) pw01 = pw01 + 1;
            end
            if (pw01 === 0) begin
                $display("PASS [TC01_no_pw_in_prefetch] pool_write=0 in first 14 cycles  (%0t ns)", $time - tc_t0);
                pass_cnt = pass_cnt + 1;
            end else begin
                $display("FAIL [TC01_no_pw_in_prefetch] got %0d pool_writes in first 14 cycles  (%0t ns)", pw01, $time - tc_t0);
                fail_cnt = fail_cnt + 1;
            end
        end

        // ── TC02 + TC03: Count pool_writes during full Conv1 ───────────
        // Conv1 OUT_LEN=500; pool_write fires every 5 cycles (pool stride=5)
        // Total Conv1 cycles ≈ 2500 + pipeline ≈ 2520 cycles
        // Wait for CONV1→CONV2 transition (bank_sel toggle)
        tc_t0 = $time;
        begin : tc02_03
            integer pw_cnt2, last_pw_pong, i_cyc;
            reg prev_bank_sel, cur_bank_sel;
            reg saw_transition;

            pw_cnt2 = 0;
            last_pw_pong = -1;
            saw_transition = 0;
            prev_bank_sel = bank_sel;

            // Run until layer_state==CONV2 or timeout
            for (i_cyc = 0; i_cyc < 3500 && !saw_transition; i_cyc = i_cyc + 1) begin
                @(posedge clk); #1;
                if (pool_write) begin
                    pw_cnt2 = pw_cnt2 + 1;
                    last_pw_pong = pong_addr;
                end
                if (layer_state === CONV2 && !saw_transition) saw_transition = 1;
            end

            // TC02: pong_addr should have reached 499 at last pool_write
            if (last_pw_pong === 499) begin
                $display("PASS [TC02_pong_addr_max] last pong_addr=%0d  (%0t ns)", last_pw_pong, $time - tc_t0);
                pass_cnt = pass_cnt + 1;
            end else begin
                $display("FAIL [TC02_pong_addr_max] expected=499 got=%0d  (%0t ns)", last_pw_pong, $time - tc_t0);
                fail_cnt = fail_cnt + 1;
            end

            // TC03: exactly 500 pool_writes for Conv1
            if (pw_cnt2 === 500) begin
                $display("PASS [TC03_pool_write_count_500] count=%0d  (%0t ns)", pw_cnt2, $time - tc_t0);
                pass_cnt = pass_cnt + 1;
            end else begin
                $display("FAIL [TC03_pool_write_count_500] expected=500 got=%0d  (%0t ns)", pw_cnt2, $time - tc_t0);
                fail_cnt = fail_cnt + 1;
            end
        end

        // At this point layer_state should be CONV2
        // ── TC04: layer_state reached CONV2 ────────────────────────────
        tc_t0 = $time;
        if (layer_state === CONV2) begin
            $display("PASS [TC04_state_conv2] layer_state=%0d  (%0t ns)", layer_state, $time - tc_t0);
            pass_cnt = pass_cnt + 1;
        end else begin
            $display("FAIL [TC04_state_conv2] expected=%0d got=%0d  (%0t ns)", CONV2, layer_state, $time - tc_t0);
            fail_cnt = fail_cnt + 1;
        end

        // ── TC05: bank_sel = 1 after Conv1 (toggled from 0) ───────────
        tc_t0 = $time;
        if (bank_sel === 1'b1) begin
            $display("PASS [TC05_bank_sel_toggle] bank_sel=%0d  (%0t ns)", bank_sel, $time - tc_t0);
            pass_cnt = pass_cnt + 1;
        end else begin
            $display("FAIL [TC05_bank_sel_toggle] expected=1 got=%0d  (%0t ns)", bank_sel, $time - tc_t0);
            fail_cnt = fail_cnt + 1;
        end

        // ── TC06: cp_en=0x0F during Conv1 (was tested during Conv1 run)
        // Verify cp_en is 0xFF now (Conv2 uses 4 channels → cp_en=0x0F)
        // Actually Conv2 also has cp_en=0x0F; Conv3/4 have 0xFF
        // We check the static assignment: cp_en should be 0x0F for CONV2 as well
        tc_t0 = $time;
        if (cp_en === 8'h0F) begin
            $display("PASS [TC06_cp_en_conv2] cp_en=0x%02X  (%0t ns)", cp_en, $time - tc_t0);
            pass_cnt = pass_cnt + 1;
        end else begin
            $display("FAIL [TC06_cp_en_conv2] expected=0x0F got=0x%02X  (%0t ns)", cp_en, $time - tc_t0);
            fail_cnt = fail_cnt + 1;
        end

        // ── TC07: pong_we[4..7] = 0 during Conv1/Conv2 (cp_en[4..7]=0) ─
        // Since we're now in Conv2, pong_we[4..7] should remain 0 for this layer
        // Just verify the current cp_en bit [7:4] are 0
        tc_t0 = $time;
        if (cp_en[7:4] === 4'h0) begin
            $display("PASS [TC07_pong_we_upper_gated] cp_en[7:4]=0  (%0t ns)", $time - tc_t0);
            pass_cnt = pass_cnt + 1;
        end else begin
            $display("FAIL [TC07_pong_we_upper_gated] cp_en[7:4]=%0b expected=0  (%0t ns)", cp_en[7:4], $time - tc_t0);
            fail_cnt = fail_cnt + 1;
        end

        // ── TC08: Wait for Conv2 complete, verify cp_en=0xFF for Conv3 ─
        // Run Conv2 + Conv3 to check cp_en transition to 0xFF
        tc_t0 = $time;
        begin : tc08
            reg saw_conv3;
            reg saw_ff;
            integer tc8_t;
            saw_conv3 = 0;
            saw_ff = 0;

            for (tc8_t = 0; tc8_t < 5000 && !saw_conv3; tc8_t = tc8_t + 1) begin
                @(posedge clk); #1;
                if (layer_state === 3'd4) saw_conv3 = 1;  // CONV3
                if (cp_en === 8'hFF) saw_ff = 1;
            end

            if (saw_ff) begin
                $display("PASS [TC08_cp_en_ff_conv3_4] cp_en reached 0xFF  (%0t ns)", $time - tc_t0);
                pass_cnt = pass_cnt + 1;
            end else begin
                $display("FAIL [TC08_cp_en_ff_conv3_4] cp_en never reached 0xFF  (%0t ns)", $time - tc_t0);
                fail_cnt = fail_cnt + 1;
            end
        end

        // ── Summary ────────────────────────────────────────────────────
        $display("=== tb_layer SUMMARY: %0d PASS, %0d FAIL ===", pass_cnt, fail_cnt);
        $finish;
    end

    // Timeout watchdog — full Conv1 takes ~2520 cycles; give Conv1+2+3 headroom
    initial begin
        #600000;
        $display("TIMEOUT — simulation exceeded 600us");
        $finish;
    end

    // Optional: VCD dump for waveform analysis
    initial begin
        $dumpfile("tb_layer.vcd");
        $dumpvars(0, tb_layer);
    end

endmodule
