Haveroahl/1D-CNN-Accelerator-for-ECG-Arrhythmia-Classification-on-FPGA/(commit log)

2026-05-18 baseline: project state after ping_pong_sram revert to flat layout
    - ping_pong_sram.v: flat mem_a/mem_b [0:3999], 1cy sync read.
    - tb_top.v / tb_top_probe.v: read_mem_a/b helpers use flat ch*500+pos index.
    - Sim verified: 8/8 TC PASS, L2 21/21 bit-exact PASS, cycles=2608.
    - Quartus timing not yet closed at 100 MHz (slack -1.9 ns).
    [qat_log.csv, train_log.csv]
2026-06-01 hw: reload new QAT-INT8 checkpoint, re-verify bit-exact
    Re-export weights + regenerate golden from the updated qat_int8
    checkpoint (copied from WSL re-train) and sync into RTL + Questa
    workdir. Recreate ecg_sample{0,1,2}.hex from each sample's golden
    input so testbench inputs match goldens.
    Verification (Questa):
    - tb_top: 9 PASS / 0 FAIL (21/21 bit-exact, 3 samples x 7 stages,
    argmax 3/1/2, 5216 cycles)
    - tb_top_probe: 7 PASS / 0 FAIL
    - tb_layer: 8 PASS / 0 FAIL
    - tb_cp_block: pre-existing stale-harness failures (8/14), identical
    against baseline HEAD cp_block.v -> unrelated to this change
    Also: rename export_weights_int8_new.py -> export_weights_int8.py
    (drops legacy flat_weights.hex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
    [cnn_controller.v, cp_block.v, cp_engine.v, ecg_accelerator_top.v, gap_fc_argmax.v]
2026-06-01 hw/test: fix tb_cp_block, add testplan + coverage scripts
    tb_cp_block: fix stale unit-test harness (was 8/22 PASS at baseline,
    unrelated to RTL). Root cause: S9 pool counts a pixel only while
    (relu_v && compute_en_in), but relu_v lags out_valid by 9 stages and
    the driver dropped compute_en_in too early, so pooled pixels were
    never counted (pool_out stuck at 0). Fix is testbench-only (RTL
    unchanged):
    - drain_pipeline(): hold compute_en_in high with a_in parked off the
    valid slot so in-flight pixels reach the pool with no new out_valid
    - latch pool_write/pool_out/pool_count so checks read them regardless
    of when the 1-cycle pulse fired
    - rework per-pixel-bias TC10/TC11 as one contiguous 5-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
    [tb_cp_block.v]
2026-06-01 hw/test: add tb_fsm to close FSM-transition coverage gap
    tb_top exercises the FSM once (IDLE→LOAD→CONV1..4→GAP_FC→DONE), leaving
    the streaming re-start edge DONE_S→LOAD_INPUT uncovered. tb_fsm runs two
    back-to-back inferences (cold start, then warm re-start without rst),
    monitors every layer_state edge, and asserts all 8 main-FSM edges fire.
    Result: tb_fsm 8 PASS / 0 FAIL ("ALL FSM EDGES COVERED"). Other TBs
    unaffected (tb_cp_block 22/22, tb_layer 8/8, tb_top 9/9).
    Measured coverage after adding tb_fsm (merge of 4 TBs):
    Statement 91.27→93.20%, Branch 84.39→86.99%, FSM-state 71.4→80.95%.
    Main control-FSM: 100% of valid edges. testplan.txt updated with the
    new section, matr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
    [tb_fsm.v]
2026-06-01 hw/test: add avalon read-default case; confirm no other TB needed
    Coverage gap analysis (per-module, in tb_top where each module runs
    fully) shows functional coverage is already high and the remaining
    misses are defensive:
    cp_block/ping_pong 100/100%, cp_engine 100/89%, gap_fc 100/94.9%,
    avalon 100/93.8%, controller 96.9/90.9%.
    The only reachable functional gap was the avalon read default branch
    (unmapped address). Added TC_avalon_read_default to tb_top (read 0x1F
    -> 0), bringing avalon statement 94.4->100%, branch 87.5->93.8%.
    tb_top now 10 PASS / 0 FAIL.
    Verified the argmax tie-break paths (gap_fc lines 196/200/204) are
    already 2/2 branches = 100% — no argmax TB needed. All other mi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
    [tb_top.v]
2026-06-01 Phase A: cross-dataset evaluation Chapman -> PTB-XL (contribution C3)
    - ptbxl_preprocess.py: patient-independent split, 19952 records, 4-class mapping
    - ptbxl_eval.py: 6-mode eval (C1-C6) zero-shot/linear probe/finetune/scratch/float
    - unpruned_zeroshot.py: ablation A5 pruned vs unpruned transfer comparison
    - ptbxl_cross_eval.json: results C1=94.46% C2=77.14% C3=92.49% C4=93.29% C5=92.79%
    - A_Crosscheck.txt: full results summary with confusion matrices and key findings
    - flow_software.md: updated to Windows paths + PTB-XL Phase A commands
    Key findings: quant drop=0% (C2==C6), linear probe recovers to 92.5%,
    SB/SR confusion is clinical boundary issue not architecture weakness,
    pruning 47% pa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
2026-06-01 hw/test: close FEC condition/expression to 100% (TC19 + 1 exclusion)
    Push focused condition/expression (FEC) coverage to 100%, distinguishing
    reachable cases (must test) from unreachable ones (exclude):
    - TC19 (tb_cp_block): the `relu_v && compute_en_in` pool gate
    (cp_block:181) had an uncovered FEC row — relu_v=1 while
    compute_en_in=0 (valid data reaches the pool but compute is gated off).
    This combination IS reachable, so it must be tested, not excluded. TC19
    streams pixels until relu_v rises, drops compute_en_in on that cycle,
    and asserts pool_cnt does not advance. Closes Condition 98.55% -> 100%.
    tb_cp_block now 23 PASS / 0 FAIL.
    - cov_exclude.do: exclude pong_we ch0-3 FE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
    [tb_cp_block.v]
2026-06-01 docs: correct FSM-transition explanation in testplan
    Earlier commits/testplan wrongly attributed the 42% FSM-transition
    figure to "gap_fc step-counters (non-control)". The coverage report
    shows the truth: the two recognized FSMs are layer_state (controller)
    and fc_sub_state (gap_fc) — both REAL control FSMs.
    42% (16/38) is a Questa over-approximation, not a verification gap:
    because every `state <=` assignment lives in one case block, Questa
    generates a transition bin for every state-to-state pair. The 16 covered
    transitions are exactly every edge the linear pipeline allows
    (IDLE→LOAD→CONV1..4→GAP_FC→DONE, plus DONE→LOAD streaming and
    DONE→IDLE). The 22 uncovered ones are non-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
2026-06-02 Phase A': quantization ablation (Table 4) + Chapman CM/ROC + doc cleanup
    Contribution C1 — quant ablation matrix (train-method x scale-type), all
    bit-exact INT8 eval on pruned model (4,4,8,8):
    - A0 PTQ power-of-2 94.08% / F1 0.9338 / +0 DSP
    - A0' PTQ general-scale 94.46% / F1 0.9380 / +4 DSP
    - A2 QAT power-of-2 (ours) 94.37% / F1 0.9364 / +0 DSP
    - A3 QAT general-scale 94.65% / F1 0.9398 / +4 DSP
    - A4 QAT power-of-2 floor 93.99% / F1 0.9328 / +0 DSP
    New scripts: ptq_int8.py (A0), ptq_int8_general.py (A0'), qat_int8_general.py
    (A3), qat_int8_floor.py (A4), run_ablation_quant.py, run_kfold_quant.py,
    chapman_cm_roc.py. Results in results/ablation_quant/TABLE4_FINAL.md + fi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
2026-06-04 Phase C: PowerPlay VCD setup + CPU latency benchmark
    - tb_top.v: dump u_top subtree (not tb_top) so VCD root aligns with
    synthesized top entity for PowerPlay; bit-exact verify unaffected (21/21 PASS).
    - ecg_accelerator_top.qsf: add PowerPlay VCD input assignments (tb_top.vcd).
    - probe_pow.tcl / run_pow.tcl: PowerPlay power-analysis helper scripts.
    - benchmark_latency.py: CPU compute-only baseline (pruned 4,4,8,8 FP32)
    for FPGA-vs-CPU speedup; INT8 sim marked reference-only.
    Measured (in output_files/, gitignored): DSP 28/112, ALM 5%, Fmax ~105MHz,
    total 623mW / dynamic 198mW / static 413mW, energy 10.3uJ dynamic, 4.31 GOP/s.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
2026-06-04 Phase B: split bus-agnostic ecg_core from Avalon wrapper
    Extract isram+pp+cpe+gfa+ctrl into ecg_core.v with an 8-wire interface
    (sram_wr_addr/din/we + start/busy/done/result). ecg_accelerator_top
    becomes a thin wrapper instantiating avalon_slave (bus adapter) + ecg_core.
    Pure structural refactor — no logic change. Same external ports, so the
    Quartus project and tb see no interface change.
    Enables Phase D: soc_top/Qsys can reuse the verified core under an HPS
    wrapper without touching datapath/control. avalon_slave stays as the bus
    adapter shared by Phase C (virtual pins) and Phase D (h2f_lw bridge).
    tb_top.v: hierarchical probes retargeted u_top.X -> u_top.u_core.X;
    busy/done/result now r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
2026-06-04 Phase D prep: Qsys/HPS scaffolding + HPS driver + SDC
    Add ecg_core.v to the .qsf VERILOG_FILE list and to ecg_core_hw.tcl's
    fileset (required after the core split — the wrapper now instantiates
    ecg_core, so synth/Qsys must compile it).
    New Phase D text artifacts (GUI Platform Designer work still manual):
    - sw/hps/ecg_classify.c : user-space HPS driver. mmap lwh2f bridge
    (0xFF200000), load 2500 INT8 ECG via avs registers, start, poll done,
    read class 0..3. Register map taken from avalon_slave.v (WORDS units).
    - soc/soc_top.sdc : Phase D constraints — 50 MHz board clock,
    derive_pll_clocks for the 100 MHz core_clk, false_path on KEY0_n.
    Does NOT reuse the Phase C SDC (avs_*/clk are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
2026-06-08 Add FC bias to pipeline: bit-exact preserved + SoC accuracy demo
    FC bias was silently dropped (scaled at 2^0 -> rounds to 0). Now scaled at 2^w_shift_fc (=2^8) to be commensurate with logits = sum(gap[2^0] * w_fc[2^8]).
    Software (Python golden + export):
    - qat_int8 / qat_int8_floor / qat_int8_general: FC bias scaled per-scheme (power-of-2: round(b*2^w_shift_fc); general: round(b/s_acc_fc))
    - export_weights_int8.py: emit fc_bias.hex (4x INT32), w_shift-aware metadata
    - generate_golden.py + model.py: FC forward seeds scaled bias (drop b_fc==0 assert)
    - re-export weights + re-gen 3-sample golden from re-trained checkpoint
    RTL:
    - gap_fc_argmax.v: readmemh fc_bias.hex, seed fc_acc[k]=bias at fc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
2026-06-09 cov scripts: fix Phase B + FC-bias drift, re-verify 100% functional coverage
    The cov_*.do scripts predated the Phase B ecg_core split and the FC-bias
    commit, so they no longer ran against current RTL:
    - cov_tb_{layer,fsm,top}.do: add ecg_core.v to compile list (top now
    instantiates ecg_core u_core; missing module -> compile fail).
    - cov_exclude.do: gap_fc_argmax excludes drifted +12 lines after FC-bias
    fc_b seed (GAP default 106->111, argmax case 191->197). Other excludes
    (cnn_controller 239/273/288, avalon 46, cp_engine 290) still correct.
    - cov_merge_report.do: add -du ecg_core to merge; replace nested
    `vsim -viewcov {... quit -f}` with `coverage open + do cov_exclude.do`
    so the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
2026-06-09 Add gate-level (post-synthesis) functional simulation
    New verification tier: drive the Quartus-synthesized netlist
    (ecg_accelerator_top.vo) to confirm the post-synth design (real LUT/DSP/M10K
    mapping, weights constant-folded into logic) still produces correct results.
    - tb_gate.v: black-box testbench, external Avalon ports only. Cannot reuse
    tb_top.v because the netlist flattens/renames hierarchy, breaking the 21
    hierarchical-reference checkpoints. Loads 3 ECG samples via Avalon, runs
    inference, checks argmax (5'h05) + latency (poll 5'h04 busy). No weight
    load needed — weights are constant-folded into the netlist.
    - run_tb_gate.do: compile .vo + tb_gate against cyclonev sim libs.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
    [tb_gate.v]
2026-06-11 @ Phase D onboard prep: JTAG + Nios V/m RISC-V SoC (sim 3/3 PASS, compile PASS)
    Hai variant chạy core CNN đã verify trên DE10-Standard (no HPS — Quartus Lite):
    - JTAG-to-Avalon: PC stream ECG qua System Console (ecg_jtag_console.tcl),
    full Chapman accuracy. jtag_top.v + jtag_system.qsys.
    - Nios V/m SoC (GV yêu cầu "sim hệ thống + main.c"): RISC-V soft-core host
    điều khiển ecg_core qua Avalon. main.c nạp 3 sample ECG nhúng -> inference
    -> printf class qua JTAG UART. Sim Questa PASS 3/3 (class 3/1/2 khớp golden,
    latency ~5216cy). niosv_top.v + nios_system.qsys + sw/niosv/.
    Hạ tầng:
    - ecg_core_hw.tcl: thêm SIM_VERILOG fileset (sim Qsys) + fc_bias.hex (gap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
2026-06-11 @ Add per-variant Quartus projects: niosv_top + jtag_top (shared ecg_common.qsf)
    Switching Phase D variants previously meant hand-editing 4 lines in
    ecg_accelerator_top.qsf (TOP_LEVEL_ENTITY + SDC/VERILOG/QIP block), easy to get
    wrong. Now each variant is its own project — open the .qpf, no manual switching:
    niosv_top.qpf -> Nios V/m RISC-V SoC (CPU + RAM + JTAG UART + ecg_core)
    jtag_top.qpf -> JTAG-to-Avalon master (PC drives ecg_core, full accuracy)
    Both `source ecg_common.qsf` (device + RTL + weight HEX + sim/power settings) so
    the shared design list lives in one place; each adds only its own TOP / SDC /
    top.v / QIP / pins. ecg_common.qsf is sourced, never opened, so Quartus d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
2026-06-13 Phase D: add UART variant (PC serial -> ecg_core, no JTAG/Nios/HPS)
    Third Phase D on-board path. Replaces the slow JTAG/System-Console flow
    (~10h for the full Chapman set, ~8M Tcl master_write_32 transactions) with a
    UART link: uart_wrapper auto-increments the SRAM address itself, so one
    CMD_LOAD ships all 2500 bytes in a single serial write -> full sweep ~4-5 min.
    Reuses ecg_core unchanged (same 8-wire interface as avalon_slave), so the
    21/21 bit-exact verification still holds -- only the bus adapter differs.
    - RTL: uart_rx/uart_tx (8N1), uart_wrapper (CMD_LOAD/START/STATUS/RESULT
    protocol), ecg_uart_top, soc/uart_board_top (DE10-Standard board top).
    - uart_top.qsf/.qpf: standalone Quar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
    [ecg_uart_host.py, ecg_uart_top.v, tb_uart.v, uart_board_top.v, uart_rx.v, uart_tx.v, uart_wrapper.v]
2026-06-13 Phase D: overlapped input_sram reload (isram_free flag)
    Lets the next window's 2500 samples load into input_sram while Conv2/3/4/GAP
    of the current window still run, hiding load latency behind compute. Conv1 is
    the only consumer of input_sram; once state leaves CONV1 the buffer is free.
    Core changes:
    - cnn_controller: isram_free flag - set on CONV1->CONV2, cleared at LOAD_INPUT
    (Conv1 about to read again) and reset. Bit raised only after Conv1 fully
    releases input_sram, so no read/write collision with the current window.
    - ecg_core / ecg_accelerator_top: expose isram_free out to the bus adapter.
    - avalon_slave: surface isram_free in STATUS reg 0x04 bit[2] so an Avalon
    master can poll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
    [avalon_slave.v, cnn_controller.v, ecg_accelerator_top.v, ecg_core.v, tb_overlap.v]
2026-06-13 Phase D JTAG: add DATA WINDOW for burst weight/ECG load (~10h -> minutes)
    The single JTAG demo took ~10 h because each of the 2500 ECG bytes/sample
    needed 3 System-Console master_write_32 calls (din/addr/we), ~8M Tcl
    transactions for the full set. The bottleneck is per-call Tcl overhead
    (~4.5 ms), not JTAG bandwidth.
    Add an additive DATA WINDOW to avalon_slave so one block write ships a whole
    sample:
    - avalon_slave.v: avs_address 5 -> 13-bit. Legacy regs 0x00-0x05 unchanged;
    new window 0x1000-0x19C3 (addr[12]=1): a word write auto-drives
    sram_din<=wd[7:0], sram_wr_addr<=addr[11:0], sram_we<=1.
    - ecg_accelerator_top.v / ecg_core_hw.tcl: widen address to 13-bit,
    explicitAddressSpan 8192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
2026-06-14 Timing: fold bias+round_add into acc init (Fmax 105->137.6MHz, bit-exact)
    cp_block.v: move the per-layer bias and round-half-up constant into the
    accumulator init term (a_in==0) instead of two separate downstream 32-bit
    adders. S_bias becomes a passthrough and S6 becomes a pure >>> nb shift,
    removing the long add+barrel-shift from the critical path. Addition is
    associative and acc has ample headroom (|bias|<=139, round<=128, acc~4.19M)
    so the result is bit-identical, not merely within tolerance.
    Result (Quartus 5CSXFC6D6F31C6 -6, slow 85C, high-effort fit):
    internal-logic Fmax 105 -> 137.6 MHz, 0 added pipeline latency (still 5216
    cycles), resource unchanged (ALM 2182, DSP 28).
    Testbench u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
    [cp_block.v, tb_cp_block.v, tb_top_probe.v]
2026-06-14 Phase D JTAG: timestamped .log output + jtag_demo.md doc
    - ecg_jtag_console.tcl: write a timestamped ecg_jtag_<YYYYMMDD>_<HHMMSS>.log per
    run (logputs echoes to Console + file). File captures every sample with a
    per-line flush so a mid-run JTAG channel drop still leaves a usable log; the
    Console stays thinned (first 10 + every 50th). ::LOG_ENABLE toggles it.
    - jtag_demo.md: detailed JTAG-to-Avalon demo doc — architecture, the two
    separate clocks (core 100MHz PLL vs JTAG TAP ~6-24MHz), 13-bit register map +
    DATA WINDOW, host protocol, why ~10h -> minutes, run steps, and the bit-exact
    sim results.
    Re-verified on the new cp_block datapath (32f7a11): run_tb_top.do and
    run_tb_top_w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
2026-06-14 @ qsf: restore ecg_accelerator_top.qsf to Phase C standalone role
    TOP was set to niosv_top (duplicating niosv_top.qsf). Restore it to its named
    role: TOP=ecg_accelerator_top (ecg_core + avalon_slave), standalone synth/power
    /timing project. Drop Nios V (niosv_top.v + nios_system QIP), PLL (core_pll),
    niosv pins (FPGA_CLK1_50/KEY0_n), PARTITION_HIERARCHY. SDC -> 100MHz.
    Per-variant projects unchanged: niosv_top.qsf / jtag_top.qsf / uart_top.qsf
    (each sources ecg_common.qsf). Verified: quartus_map elaborates top=
    ecg_accelerator_top -> avalon_slave + ecg_core (no Nios/PLL), 0 errors.
    @
2026-06-15 Phase B01: runtime weight reload via Avalon (conv weights -> M10K)
    Replace the bitstream-baked conv weight ROMs with a runtime-loadable path so
    the PC can push weights to the board over the bus (enabling C3 cross-dataset:
    same .sof runs Chapman or PTB-XL weights).
    - cp_engine: 4 per-layer async FF ROMs -> 8 per-oc M10K (40b x17, word =
    layer_base+ic). M10K sync-read replaces the old w_packed FF stage 1:1, so
    pipeline alignment with mux_s1 is unchanged (bit-exact). Add conv-weight +
    bias write ports. $readmemh init guarded by NO_WEIGHT_INIT.
    - gap_fc_argmax: add FC weight/bias write ports; guard $readmemh.
    - avalon_slave: 13->14-bit address; weight window (addr[13]=1) with conv /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
    [avalon_slave.v, cp_engine.v, ecg_accelerator_top.v, ecg_core.v, gap_fc_argmax.v]
2026-06-15 Phase C: pin clk for stable standalone timing + report numbers
    - ecg_accelerator_top.qsf: assign clk -> PIN_AF14 (dedicated clock pin). Without
    it the unassigned clk routed through a CLKENA buffer (+6.6ns), making I/O setup
    slack non-deterministic across compiles (one run showed a spurious -5.767ns).
    Pinned -> global clock tree -> stable, repeatable numbers. Standalone now:
    setup +0.821ns, Fmax 108.94 MHz, 0 violation.
    - PAPER_DATA.md: add §3b (production + Phase B01 weight-RAM: ALM 2,201->2,820,
    DSP 28 unchanged, M10K 20->28, Fmax 108.94, latency unchanged 5,216cy; note the
    +619 ALM is runtime-load control logic, NOT the M10K which is 0 ALM). Add DSE
    throughput rows (1.89x @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
2026-06-17 Phase B01/C3: PTB-XL cross-dataset enabling + channel-scalable verify
    Runtime-reconfigurable topology now proven for arbitrary 1..8 channels/layer
    and for a real cross-dataset deployment, all on a single bitstream.
    Verify (bit-exact):
    - tb_topo_sweep.v (new): manifest-driven 48/48 coverage sweep — every out_ch
    1..8 at every layer position + monotone/non-monotone (3,1,7,5)(8,1,8,1) +
    random. Proves RTL handles any 1..8/layer, not just powers of two. Latency
    varies 32.12us (1,1,1,1) -> 76.54us (8,8,8,8).
    - tb_topo.v: 11/11 incl. new ptbxl case (real PTB-XL weights + runtime
    nb[Conv3]=7 vs Chapman 6) bit-exact 4/4 logits, argmax matches truth.
    PTB-XL deployment chain:
    - qat_ptbxl.py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
2026-06-18 Refactor: split cp_block into cp_mac/cp_accumulate_rescale/cp_pool
    Structurally decompose the monolithic cp_block pipeline into three
    submodules (no logic change, bit-exact):
    - cp_mac S1->S4 : 5 MULT + 3-stage adder tree
    - cp_accumulate_rescale S5->S8 : acc (fold bias+round) -> >>>nb -> clamp -> ReLU
    - cp_pool S9 : MaxPool rolling comparator
    cp_block.v becomes a thin wrapper. Port taps_in renamed to x_in.
    tb_top.v adds TC08/09/10 (runtime topology config write/consume/recover,
    GAP out_ch_mask, weight-RAM depth-32 top-word). Sim do-files updated to
    compile the three new submodules.
    Regression (Questa, tb_top): 15 PASS / 0 FAIL, L2 bit-exact 21 PASS / 0 F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
    [avalon_slave.v, cnn_controller.v, cp_accumulate_rescale.v, cp_block.v, cp_engine.v, cp_mac.v, cp_pool.v, ecg_accelerator_top.v]
2026-06-18 docs: Phase E SoTA tables + E01 references + ICDV draft
    Phase E — SoTA comparison (SOTA_TABLE.md), all entries verified from
    primary sources (no snippet-only rows):
    - Table A: 5 software models on Chapman (cols Params + Beat/Rhythm).
    All rhythm-level; leverage = 654 params vs 5.31M (LightX3ECG) at same
    4-superclass task.
    - Table B: 10 FPGA biomedical accelerators (cols Freq + Throughput +
    Beat/Rhythm). Liu 2023 verified from Article.xml: INT8 92.95% < ours
    94.65% (+1.7pp), same Chapman/Cyclone V.
    Phase E01 — references (paper/REFERENCES.md), 19 entries (>=15 required),
    ICDV format with DOI/ISSN/ISBN, limited Internet links. 16/19 have
    DOI/ISBN verified; remaining fla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
